daverowntree/SmartDesk/KiCAD5/SmartDesk_v1p0-PCB-top-3D.png

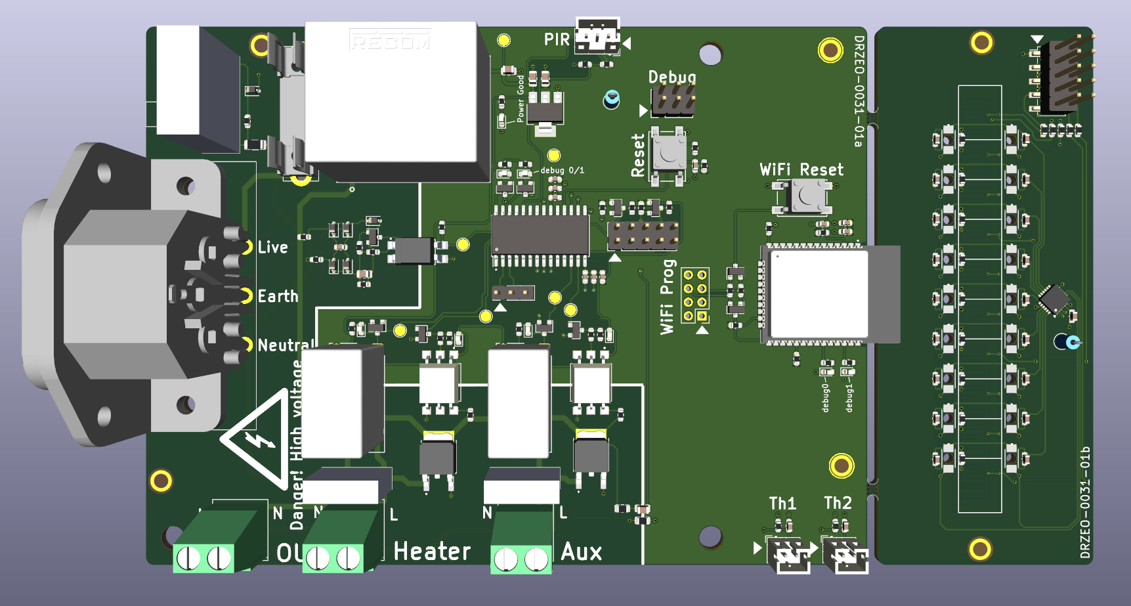
KiCAD5/SmartDesk_v1p0-PCB-top-3D.png
