daverowntree/SmartDesk/KiCAD5/ESP32_Pinout.jpg

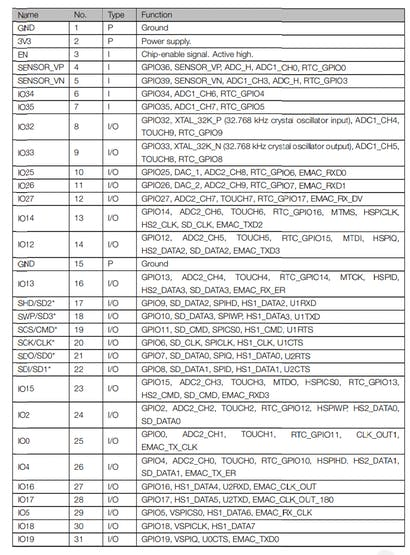
KiCAD5/ESP32_Pinout.jpg
