daverowntree/SmartDesk/KiCAD5/Screenshot from 2024-06-14 21-21-42.png

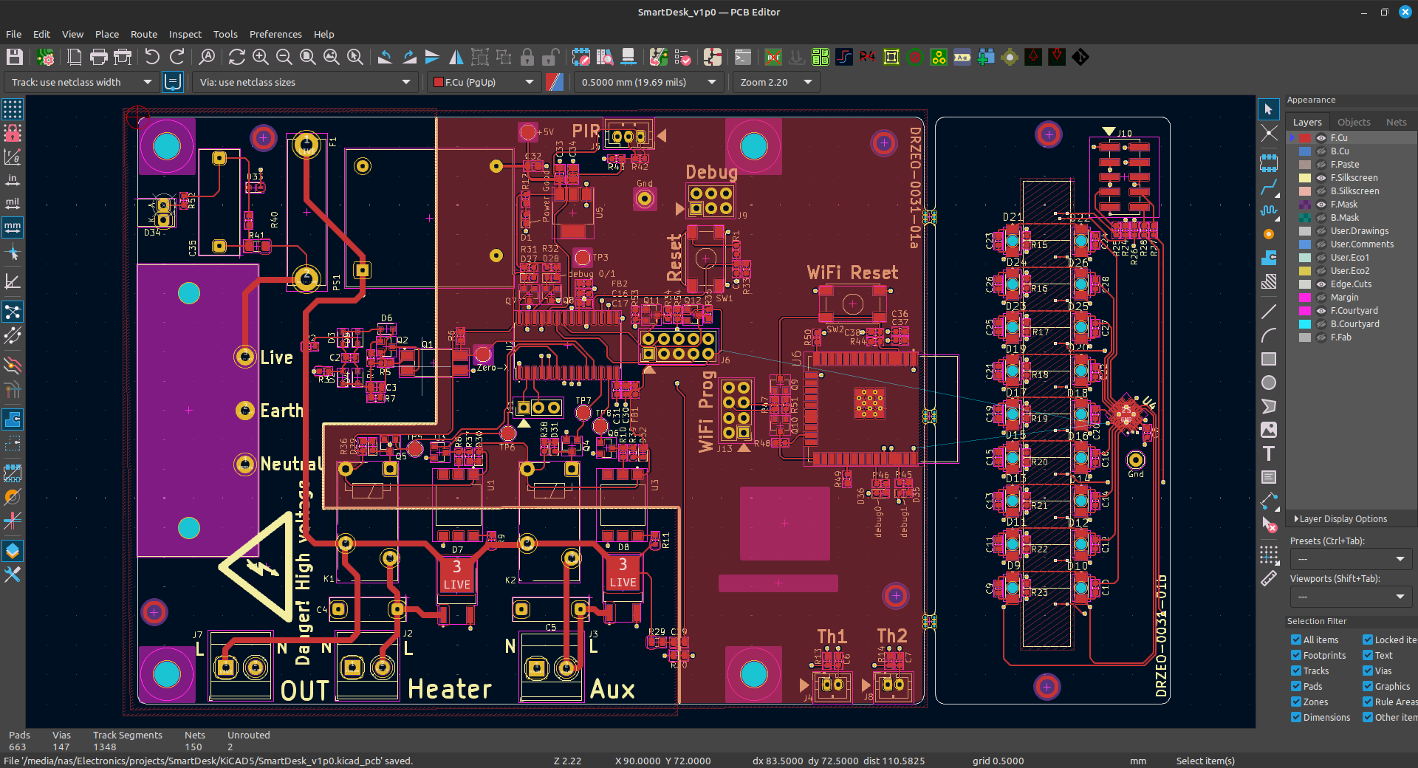
KiCAD5/Screenshot from 2024-06-14 21-21-42.png
