daverowntree/SmartDesk/KiCAD5/SmartDesk_v1p0-PCB-bot-3D.png

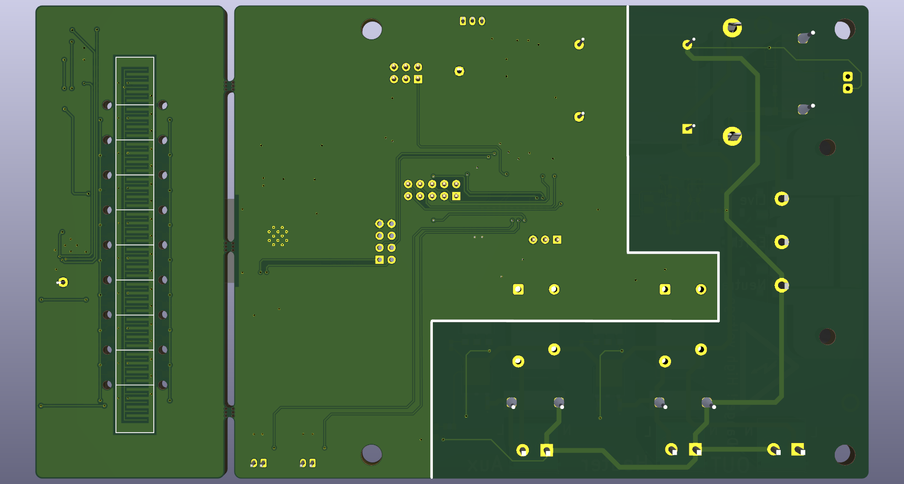
KiCAD5/SmartDesk_v1p0-PCB-bot-3D.png
