daverowntree/SmartDesk/KiCAD5/triacDriver.png

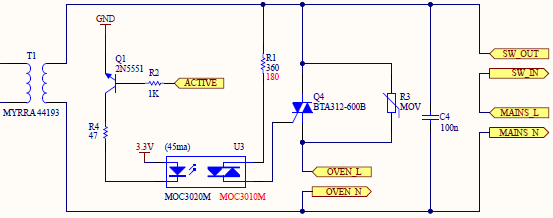
KiCAD5/triacDriver.png
