daverowntree/SmartDesk/KiCAD5/zcd2.gif

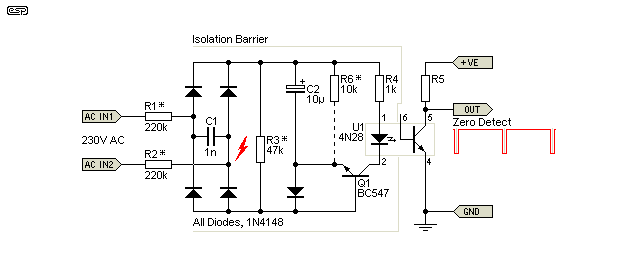
KiCAD5/zcd2.gif
