daverowntree/SmartDesk/KiCAD5/zcd.png

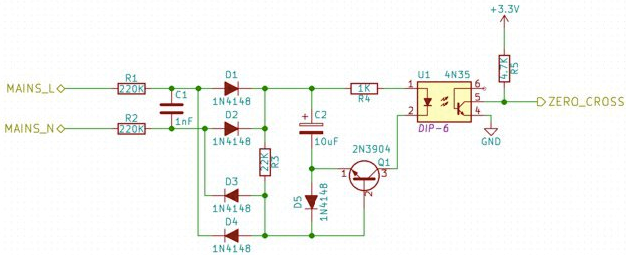
KiCAD5/zcd.png
