daverowntree/SmartDesk/FreeCAD/TE-Relay.step

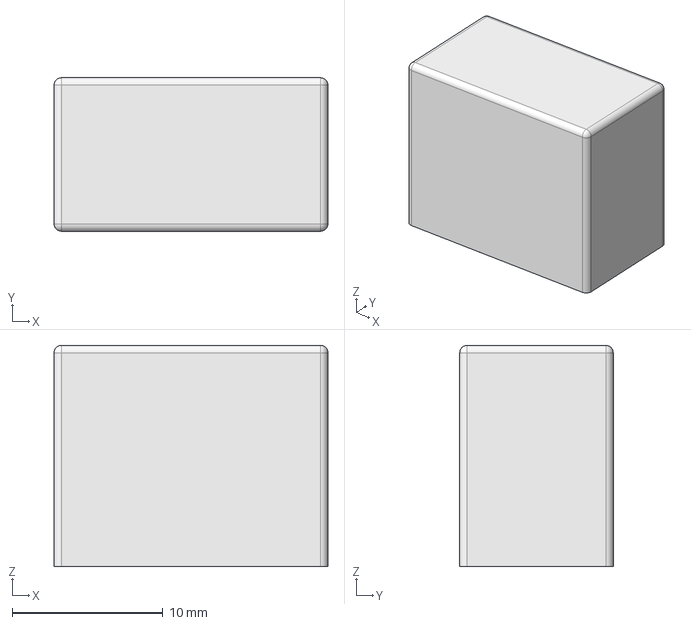
[picture p8: CAD file, 2024-06-14]
FreeCAD/TE-Relay.step
18.2 x 10.2 x 14.7 mm
