daverowntree/SmartDesk/(list of files, cad)

Other CAD files:
FreeCAD/TE-Relay.FCStd
