daverowntree/SmartDesk/LTSpice/power_indicator.asc

C2: cap; 220n
D1: LED; QTLP690C
D3: diode; 1N4148
R1: res; 100
R2: res; 1000k
V2: voltage; SINE(0 325.27 50)
Named nets: live, neutral, 0
.tran 0 5.2s 5s startup
