daverowntree/SmartDesk/LTSpice/ZCD.asc

C1: cap; 1n
C2: cap; 10µ
D1: diode; 1N4148
D2: diode; 1N4148
D3: diode; 1N4148
D4: diode; 1N4148
D5: diode; 1N4148
Q1: npn; BC547B
R1: res; 1000k
R2: res; 47k
R3: res; 250
R4: res; 4k7
R5: res; 100k
R6: res; 100k
U1: PC817A
V1: voltage; 3v3
V2: voltage; SINE(0 325.27 50)
Named nets: 0, zcd, top, bot, trig, live, neutral
.tran 0 5.2s 5s startup
