daverowntree/SmartDesk/KiCAD5/SmartDesk_v1p0.kicad_pcb

## KiCad design KiCAD5/SmartDesk_v1p0.kicad_pcb (2024-06-14)

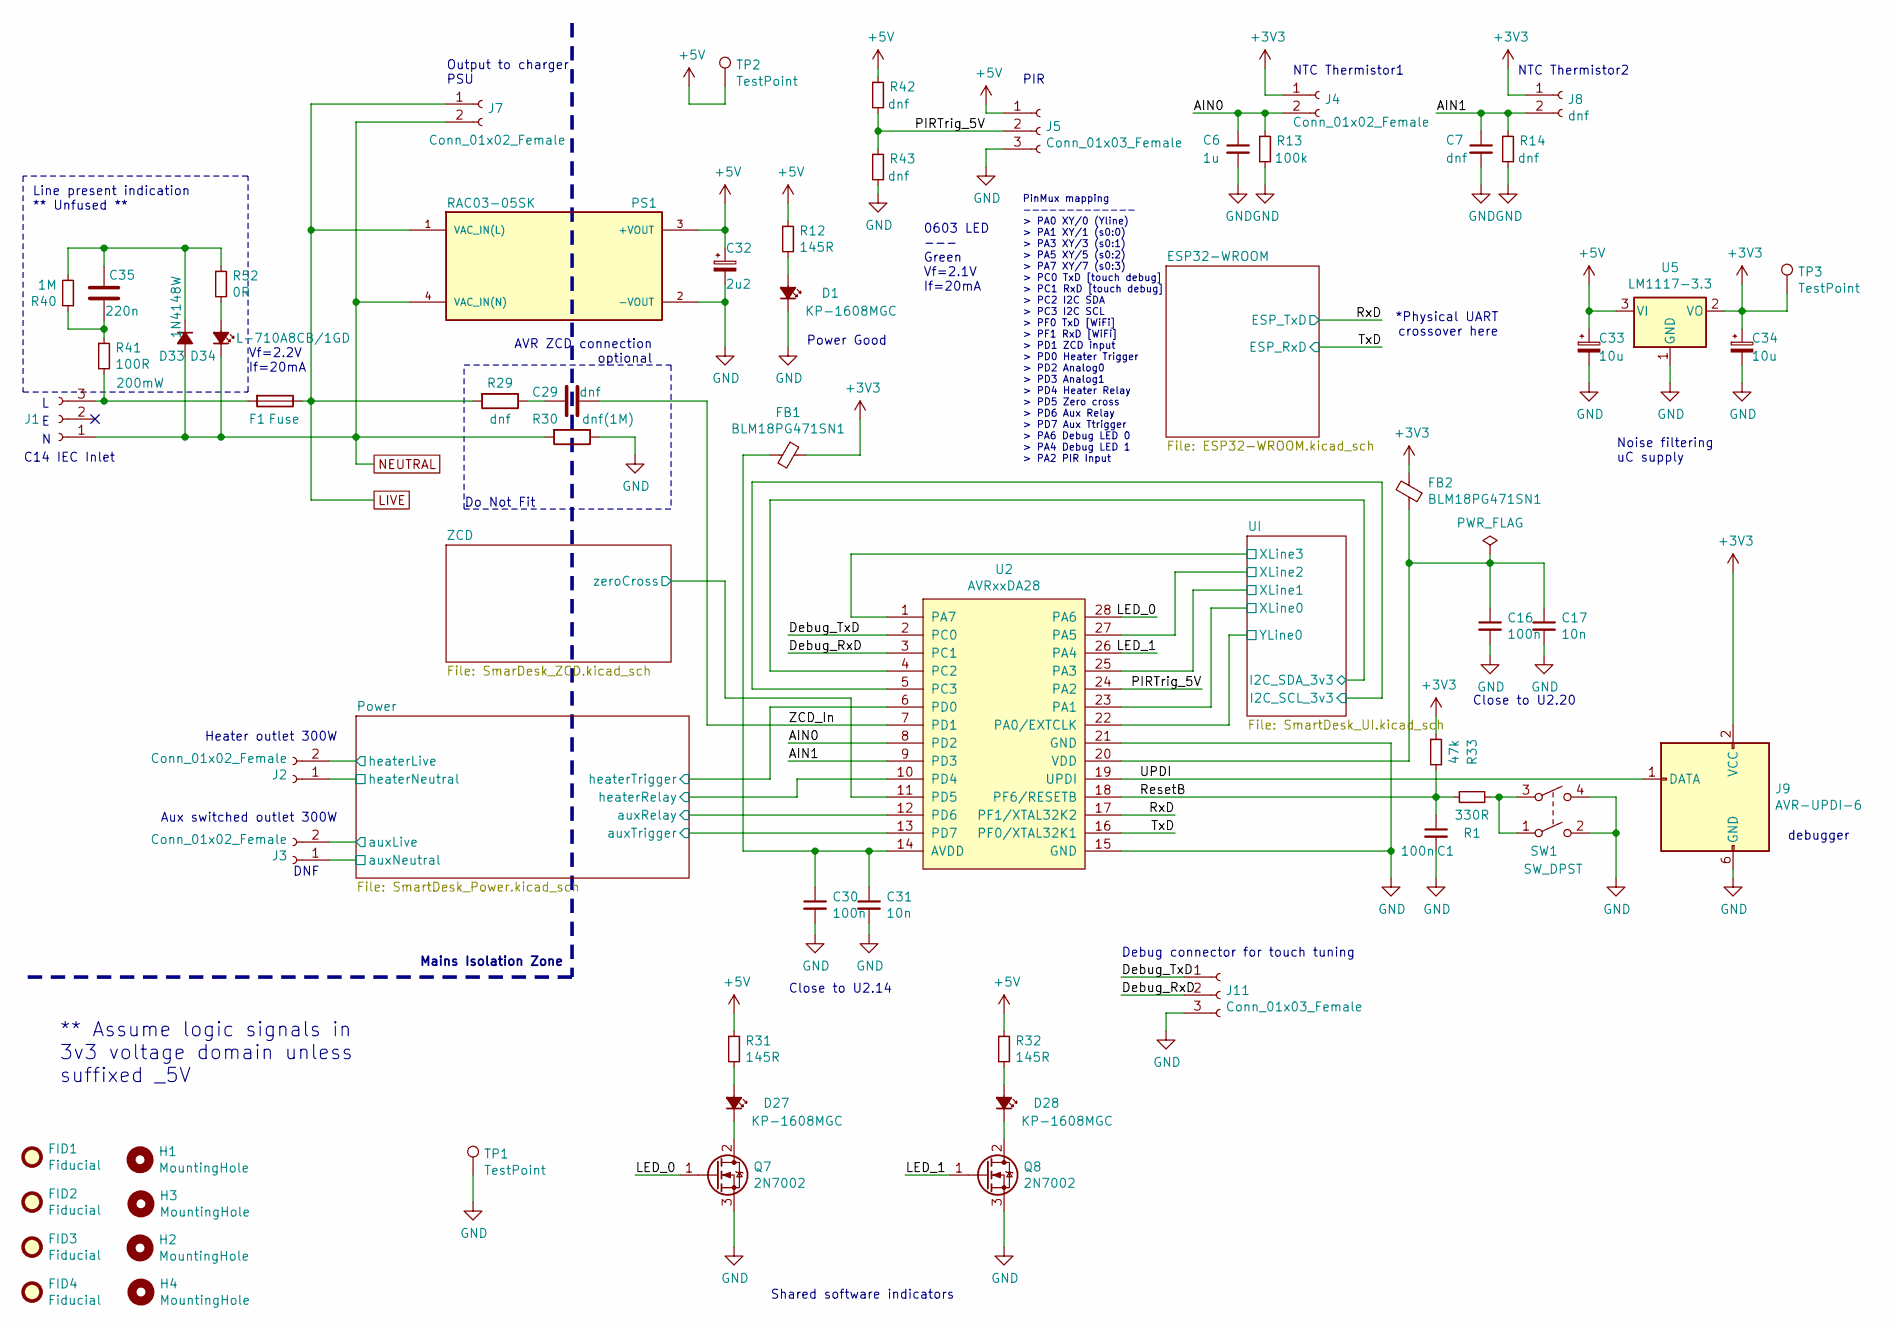
[picture p14: schematic SmartDesk_v1p0.kicad_sch, Smart Desk Main PCB]

Parts:
C1, C16, C30: 100n; C_0603_1608Metric
C6: 1u; C_0603_1608Metric
C7: dnf; C_0603_1608Metric
C17, C31: 10n; C_0603_1608Metric
C29: dnf; C_0805_2012Metric
C32: 2u2; C_0805_2012Metric
C33, C34: 10u; C_0805_2012Metric
C35: 220n; B32922C3224
D1, D27, D28: KP-1608MGC; LED_0603_1608Metric
D33: 1N4148W; D_SOD-323
D34: L-710A8CB/1GD; L-710A8CB
F1: Fuse; Bulgin-FX0321
FB1, FB2: BLM18PG471SN1; C_0603_1608Metric
FID1, FID2, FID3, FID4: Fiducial; Fiducial_Modern_CopperTop
H1, H2, H3, H4: MountingHole; MountingHole_4.3mm_M4
J1: Conn_01x03_Female; Bulgin-PX0580-PC
J2, J3, J7: Conn_01x02_Female; TerminalBlock_Phoenix_MKDS-3-2-5.08_1x02_P5.08mm_Horizontal
J4: Conn_01x02_Female; JST_PH_B2B-PH-K_1x02_P2.00mm_Vertical
J5: Conn_01x03_Female; JST_PH_B3B-PH-K_1x03_P2.00mm_Vertical
J8: dnf; JST_PH_B2B-PH-K_1x02_P2.00mm_Vertical
J9: AVR-UPDI-6; PinHeader_2x03_P2.54mm_Vertical
J11: Conn_01x03_Female; PinHeader_1x03_P2.54mm_Vertical
PS1: RAC03-05SK; CONV_RAC03-05SK
Q7, Q8: 2N7002; SOT-23
R1: 330R; R_0603_1608Metric
R12, R31, R32: 145R; R_0603_1608Metric
R13: 100k; R_0603_1608Metric
R14, R42, R43: dnf; R_0603_1608Metric
R29: dnf; R_0805_2012Metric
R30: dnf(1M); R_0805_2012Metric
R33: 47k; R_0603_1608Metric
R40: 1M; R_0603_1608Metric
R41: 100R; R_1206_3216Metric
R52: 0R; R_0603_1608Metric
SW1: SW_DPST; 2-1437565-8
TP1: TestPoint; TestPoint_Loop_D1.80mm_Drill1.0mm_Beaded
TP2, TP3: TestPoint; TestPoint_Pad_D2.0mm
U2: AVRxxDA28; SOIC-28W_7.5x17.9mm_P1.27mm
U5: LM1117-3.3; SOT-223-lm1117

Connections:
+3V3: C34.1, FB1.1, FB2.2, J4.1, J8.1, J9.2 (VCC), R33.1, TP3.1, U5.2 (VO); also elsewhere on the board
+5V: C32.1, C33.1, J5.1, PS1.3 (+VOUT), R12.1, R31.1, R32.1, R42.1, TP2.1, U5.3 (VI); also elsewhere on the board
/AIN0: C6.1, J4.2, R13.1, U2.8 (PD2)
/AIN1: C7.1, J8.2, R14.1, U2.9 (PD3)
/Debug_RxD: J11.2, U2.3 (PC1)
/Debug_TxD: J11.1, U2.2 (PC0)
/LED_0: Q7.1 (G), U2.28 (PA6)
/LED_1: Q8.1 (G), U2.26 (PA4)
/PIRTrig_5V: J5.2, R42.2, R43.1, U2.24 (PA2)
/Power/auxLive: J3.2; also elsewhere on the board
/Power/auxRelay: U2.12 (PD6); also elsewhere on the board
/Power/auxTrigger: U2.13 (PD7); also elsewhere on the board
/Power/heaterLive: J2.2; also elsewhere on the board
/Power/heaterRelay: U2.10 (PD4); also elsewhere on the board
/Power/heaterTrigger: U2.6 (PD0); also elsewhere on the board
/ResetB: C1.1, R1.2, R33.2, U2.18 (PF6/RESETB)
/RxD: U2.17 (PF1/XTAL32K2); also elsewhere on the board
/TxD: U2.16 (PF0/XTAL32K1); also elsewhere on the board
/UI/I2C_SCL_3v3: U2.5 (PC3); also elsewhere on the board
/UI/I2C_SDA_3v3: U2.4 (PC2); also elsewhere on the board
/UI/XLine0: U2.23 (PA1); also elsewhere on the board
/UI/XLine1: U2.25 (PA3); also elsewhere on the board
/UI/XLine2: U2.27 (PA5); also elsewhere on the board
/UI/XLine3: U2.1 (PA7); also elsewhere on the board
/UI/YLine0: U2.22 (PA0/EXTCLK); also elsewhere on the board
/UPDI: J9.1 (DATA), U2.19 (UPDI)
/ZCD/zeroCross: U2.11 (PD5); also elsewhere on the board
/ZCD_In: C29.1, U2.7 (PD1)
GND: C1.2, C6.2, C7.2, C16.2, C17.2, C30.2, C31.2, C32.2, C33.2, C34.2, D1.1 (K), J5.3, J9.6 (GND), J11.3, PS1.2 (-VOUT), Q7.3 (S), Q8.3 (S), R13.2, R14.2, R30.1, R43.2, SW1.2, SW1.4, TP1.1, U2.15 (GND), U2.21 (GND), U5.1 (GND); also elsewhere on the board
LIVE: F1.1, J7.1, PS1.1 (VAC_IN(L)), R29.2; also elsewhere on the board
NEUTRAL: D33.2 (A), D34.1 (K), J1.1, J2.1, J3.1, J7.2, PS1.4 (VAC_IN(N)), R30.2; also elsewhere on the board
unnamed: C16.1, C17.1, FB2.1, U2.20 (VDD)
unnamed: C29.2, R29.1
unnamed: C30.1, C31.1, FB1.2, U2.14 (AVDD)
unnamed: C35.1, R40.1, R41.1
unnamed: C35.2, D33.1 (K), R40.2, R52.1
unnamed: D1.2 (A), R12.2
unnamed: D27.1 (K), Q7.2 (D)
unnamed: D27.2 (A), R31.2
unnamed: D28.1 (K), Q8.2 (D)
unnamed: D28.2 (A), R32.2
unnamed: D34.2 (A), R52.2
unnamed: F1.2, J1.3, R41.2
unnamed: R1.1, SW1.1, SW1.3

Notes on the sheet:
DNF
Vf=2.2V If=20mA
Do Not Fit
Shared software indicators
C14 IEC Inlet
PIR
NTC Thermistor2
Close to U2.14
Mains Isolation Zone
Power Good
Heater outlet 300W
*Physical UART crossover here
Output to charger PSU
0603 LED --- Green Vf=2.1V If=20mA
Debug connector for touch tuning
Noise filtering uC supply
Line present indication ** Unfused **
PinMux mapping ------------- > PA0 XY/0 (Yline) > PA1 XY/1 (s0:0) > PA3 XY/3 (s0:1) > PA5 XY/5 (s0:2) > PA7 XY/7 (s0:3) > PC0 TxD [touch debug] > PC1 RxD [touch debug] > PC2 I2C SDA > PC3 I2C SCL > PF0 TxD [WiFi] > PF1 RxD [WiFi] > PD1 ZCD input > PD0 Heater Trigger > PD2 Analog0 > PD3 Analog1 > PD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
** Assume logic signals in 3v3 voltage domain unless suffixed _5V
Close to U2.20
debugger
Aux switched outlet 300W
NTC Thermistor1
AVR ZCD connection optional

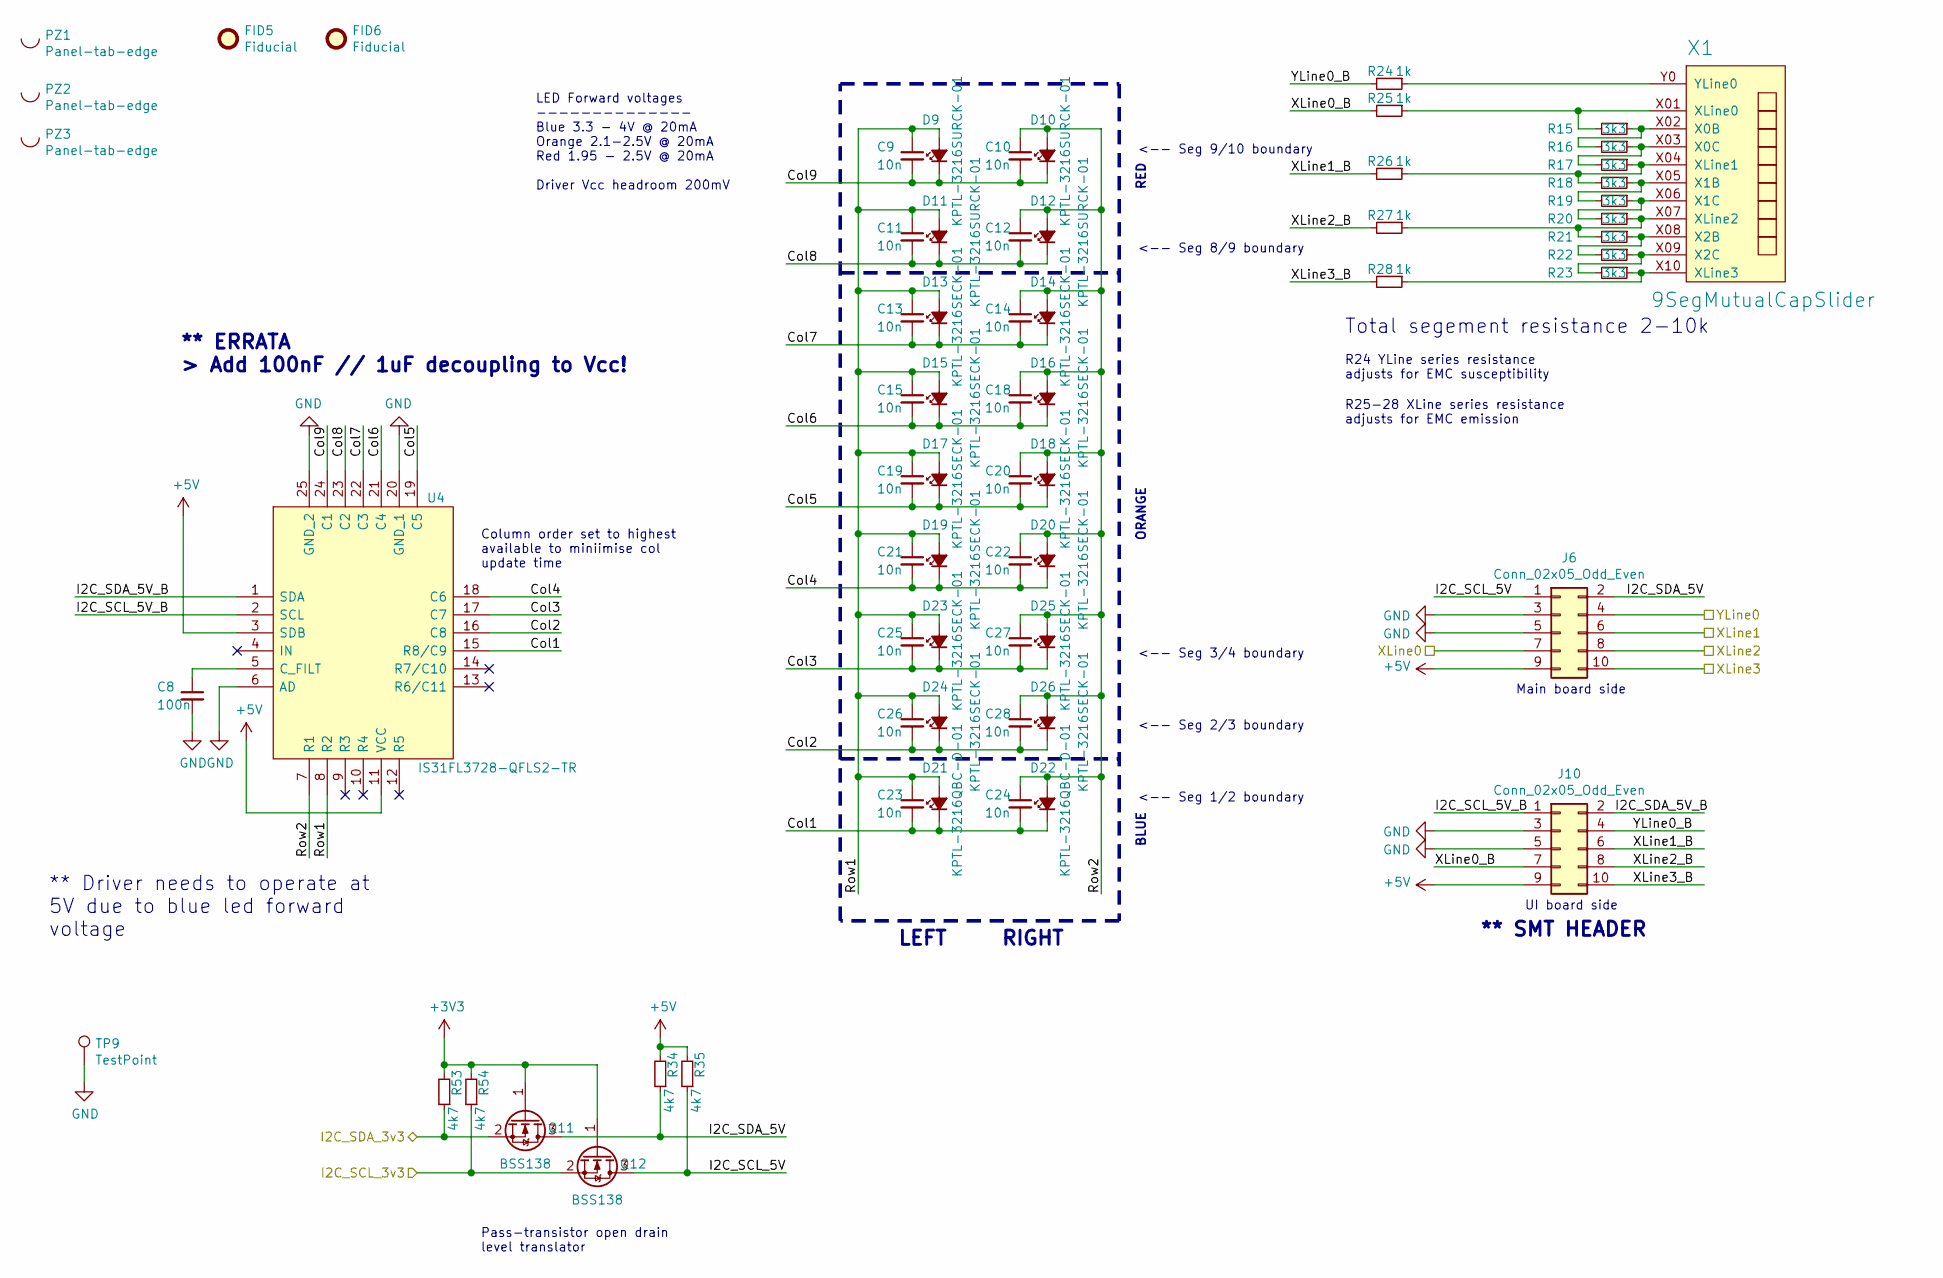
[picture p15: schematic SmartDesk_UI.kicad_sch, Smart Desk Main PCB]

Parts:
C8: 100n; C_0603_1608Metric
C9, C10, C11, C12, C13, C14, C15, C18, C19, C20, C21, C22, C23, C24, C25, C26, C27, C28: 10n; C_0603_1608Metric
D9, D10, D11, D12: KPTL-3216SURCK-01; VARC3216X102N
D13, D14, D15, D16, D17, D18, D19, D20, D23, D24, D25, D26: KPTL-3216SECK-01; VARC3216X102N
D21, D22: KPTL-3216QBC-D-01; VARC3216X102N
FID5, FID6: Fiducial; Fiducial_Modern_CopperTop
J6: Conn_02x05_Odd_Even; PinHeader_2x05_P2.54mm_Vertical
J10: Conn_02x05_Odd_Even; PinHeader_2x05_P2.54mm_Vertical_SMD
PZ1, PZ2, PZ3: Panel-tab-edge; mouse-bite-2mm-slot
Q11, Q12: BSS138; SOT-23
R15, R16, R17, R18, R19, R20, R21, R22, R23: 3k3; R_0603_1608Metric
R24, R25, R26, R27, R28: 1k; R_0603_1608Metric
R34, R35, R53, R54: 4k7; R_0603_1608Metric
TP9: TestPoint; TestPoint_Loop_D1.80mm_Drill1.0mm_Beaded
U4: IS31FL3728-QFLS2-TR; QFN50P400X400X80-25N-D; Manufacturer_Part_Number IS31FL3728-QFLS2-TR; Mouser Part Number 870-IS31FL3728QFLS2R
X1: 9SegMutualCapSlider

Connections:
+3V3: Q11.1 (G), Q12.1 (G), R53.2, R54.2; also elsewhere on the board
+5V: J6.9, J10.9, R34.2, R35.2, U4.3 (SDB), U4.11 (VCC); also elsewhere on the board
/UI/Col1: C23.2, C24.2, D21.1 (K), D22.1 (K), U4.15 (R8/C9)
/UI/Col2: C26.2, C28.2, D24.1 (K), D26.1 (K), U4.16 (C8)
/UI/Col3: C25.2, C27.2, D23.1 (K), D25.1 (K), U4.17 (C7)
/UI/Col4: C21.2, C22.2, D19.1 (K), D20.1 (K), U4.18 (C6)
/UI/Col5: C19.2, C20.2, D17.1 (K), D18.1 (K), U4.19 (C5)
/UI/Col6: C15.2, C18.2, D15.1 (K), D16.1 (K), U4.21 (C4)
/UI/Col7: C13.2, C14.2, D13.1 (K), D14.1 (K), U4.22 (C3)
/UI/Col8: C11.2, C12.2, D11.1 (K), D12.1 (K), U4.23 (C2)
/UI/Col9: C9.2, C10.2, D9.1 (K), D10.1 (K), U4.24 (C1)
/UI/I2C_SCL_3v3: Q12.2 (S), R54.1; also elsewhere on the board
/UI/I2C_SCL_5V: J6.1, Q12.3 (D), R35.1
/UI/I2C_SCL_5V_B: J10.1, U4.2 (SCL)
/UI/I2C_SDA_3v3: Q11.2 (S), R53.1; also elsewhere on the board
/UI/I2C_SDA_5V: J6.2, Q11.3 (D), R34.1
/UI/I2C_SDA_5V_B: J10.2, U4.1 (SDA)
/UI/Row1: C9.1, C11.1, C13.1, C15.1, C19.1, C21.1, C23.1, C25.1, C26.1, D9.2 (A), D11.2 (A), D13.2 (A), D15.2 (A), D17.2 (A), D19.2 (A), D21.2 (A), D23.2 (A), D24.2 (A), U4.8 (R2)
/UI/Row2: C10.1, C12.1, C14.1, C18.1, C20.1, C22.1, C24.1, C27.1, C28.1, D10.2 (A), D12.2 (A), D14.2 (A), D16.2 (A), D18.2 (A), D20.2 (A), D22.2 (A), D25.2 (A), D26.2 (A), U4.7 (R1)
/UI/XLine0: J6.7; also elsewhere on the board
/UI/XLine0_B: J10.7, R25.2
/UI/XLine1: J6.6; also elsewhere on the board
/UI/XLine1_B: J10.6, R26.2
/UI/XLine2: J6.8; also elsewhere on the board
/UI/XLine2_B: J10.8, R27.2
/UI/XLine3: J6.10; also elsewhere on the board
/UI/XLine3_B: J10.10, R28.2
/UI/YLine0: J6.4; also elsewhere on the board
/UI/YLine0_B: J10.4, R24.2
GND: C8.2, J6.3, J6.5, J10.3, J10.5, TP9.1, U4.6 (AD), U4.20 (GND_1), U4.25 (GND_2); also elsewhere on the board
unnamed: C8.1, U4.5 (C_FILT)
unnamed: R15.1, R16.2, X1.X02 (X0B)
unnamed: R15.2, R25.1, X1.X01 (XLine0)
unnamed: R16.1, R17.2, X1.X03 (X0C)
unnamed: R17.1, R18.2, R26.1, X1.X04 (XLine1)
unnamed: R18.1, R19.2, X1.X05 (X1B)
unnamed: R19.1, R20.2, X1.X06 (X1C)
unnamed: R20.1, R21.2, R27.1, X1.X07 (XLine2)
unnamed: R21.1, R22.2, X1.X08 (X2B)
unnamed: R22.1, R23.2, X1.X09 (X2C)
unnamed: R23.1, R28.1, X1.X10 (XLine3)
unnamed: R24.1, X1.Y0 (YLine0)

Notes on the sheet:
Main board side
LED Forward voltages -------------- Blue 3.3 - 4V @ 20mA Orange 2.1-2.5V @ 20mA Red 1.95 - 2.5V @ 20mA Driver Vcc headroom 200mV
RED
RIGHT
Column order set to highest available to miniimise col update time
<-- Seg 2/3 boundary
** Driver needs to operate at 5V due to blue led forward voltage
** SMT HEADER
Total segement resistance 2-10k
<-- Seg 3/4 boundary
<-- Seg 9/10 boundary
UI board side
** ERRATA > Add 100nF // 1uF decoupling to Vcc!
LEFT
<-- Seg 8/9 boundary
ORANGE
R25-28 XLine series resistance adjusts for EMC emission
R24 YLine series resistance adjusts for EMC susceptibility
<-- Seg 1/2 boundary
Pass-transistor open drain level translator
BLUE

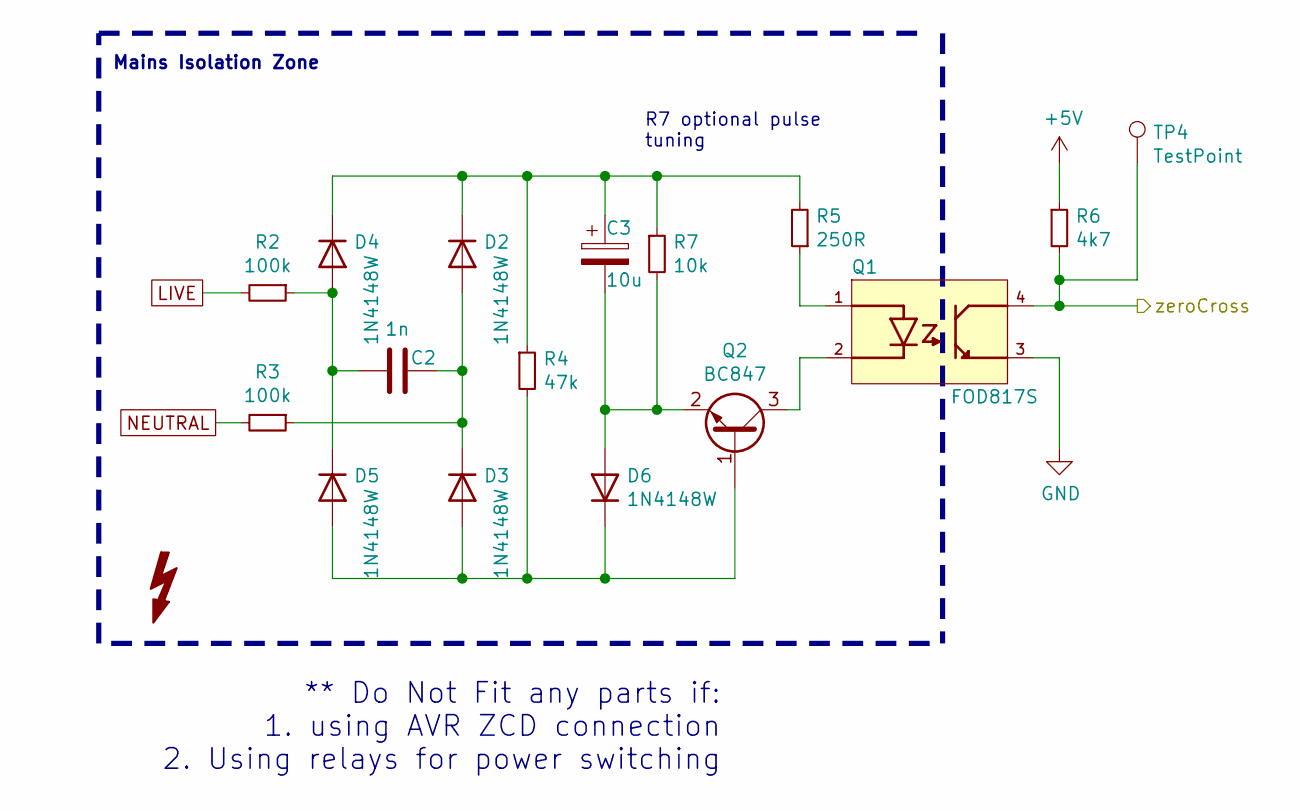
[picture p16: schematic SmarDesk_ZCD.kicad_sch, Smart Desk Main PCB]

Parts:
C2: 1n; C_0603_1608Metric
C3: 10u; C_0805_2012Metric
D2, D3, D4, D5, D6: 1N4148W; D_SOD-323
Q1: FOD817S; SOIC254P1016X385-4N
Q2: BC847; SOT-23
R2, R3: 100k; R_0603_1608Metric
R4: 47k; R_0603_1608Metric
R5: 250R; R_0603_1608Metric
R6: 4k7; R_0603_1608Metric
R7: 10k; R_0603_1608Metric
S1: SYM_Flash_Small; Symbol_Highvoltage_Type2_Silk_Small
TP4: TestPoint; TestPoint_Pad_D2.0mm

Connections:
+5V: R6.1; also elsewhere on the board
/ZCD/zeroCross: Q1.4, R6.2, TP4.1; also elsewhere on the board
GND: Q1.3; also elsewhere on the board
LIVE: R2.2; also elsewhere on the board
NEUTRAL: R3.2; also elsewhere on the board
unnamed: C2.1, D2.2 (A), D3.1 (K), R3.1
unnamed: C2.2, D4.2 (A), D5.1 (K), R2.1
unnamed: C3.1, D2.1 (K), D4.1 (K), R4.1, R5.2, R7.1
unnamed: C3.2, D6.2 (A), Q2.2 (E), R7.2
unnamed: D3.2 (A), D5.2 (A), D6.1 (K), Q2.1 (B), R4.2
unnamed: Q1.1, R5.1
unnamed: Q1.2, Q2.3 (C)

Notes on the sheet:
Mains Isolation Zone
R7 optional pulse tuning
** Do Not Fit any parts if: 1. using AVR ZCD connection 2. Using relays for power switching

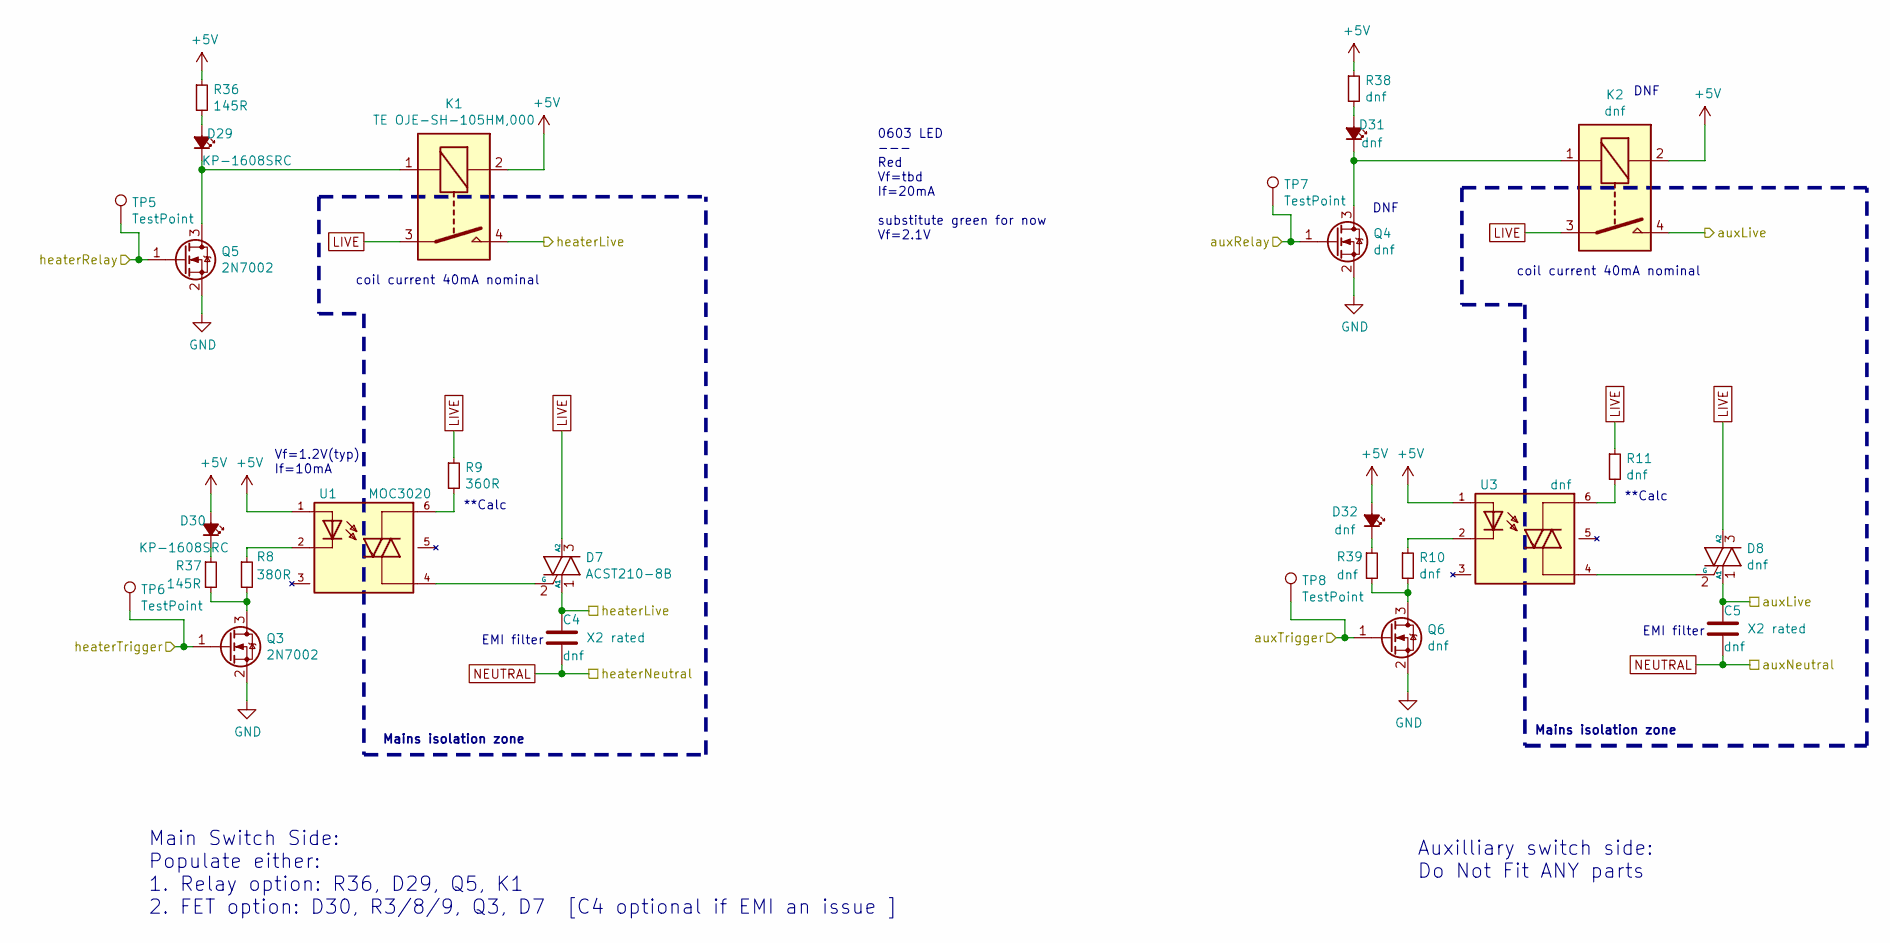
[picture p17: schematic SmartDesk_Power.kicad_sch, Smart Desk Main PCB]

Parts:
C4, C5: dnf; B32921C3223M289; Rating X2 rated
D7: ACST210-8B; DPAK228P987X240-3N
D8: dnf; DPAK228P987X240-3N
D29, D30: KP-1608SRC; LED_0603_1608Metric
D31, D32: dnf; LED_0603_1608Metric
K1: TE OJE-SH-105HM,000; TE_OJE-SH-105HM
K2: dnf; TE_OJE-SH-105HM
Q3, Q5: 2N7002; SOT-23
Q4, Q6: dnf; SOT-23
R8: 380R; R_0603_1608Metric
R9: 360R; R_0603_1608Metric
R10, R11, R38, R39: dnf; R_0603_1608Metric
R36, R37: 145R; R_0603_1608Metric
TP5, TP6, TP7, TP8: TestPoint; TestPoint_Pad_D2.0mm
U1: MOC3020; MOC302X-SON6
U3: dnf; MOC302X-SON6

Connections:
+5V: D30.2 (A), D32.2 (A), K1.2, K2.2, R36.1, R38.1, U1.1, U3.1; also elsewhere on the board
/Power/auxLive: C5.1, D8.1 (A1), K2.4; also elsewhere on the board
/Power/auxRelay: Q4.1 (G), TP7.1; also elsewhere on the board
/Power/auxTrigger: Q6.1 (G), TP8.1; also elsewhere on the board
/Power/heaterLive: C4.1, D7.1 (A1), K1.4; also elsewhere on the board
/Power/heaterRelay: Q5.1 (G), TP5.1; also elsewhere on the board
/Power/heaterTrigger: Q3.1 (G), TP6.1; also elsewhere on the board
GND: Q3.2 (S), Q4.2 (S), Q5.2 (S), Q6.2 (S); also elsewhere on the board
LIVE: D7.3 (A2), D8.3 (A2), K1.3, K2.3, R9.1, R11.1; also elsewhere on the board
NEUTRAL: C4.2, C5.2; also elsewhere on the board
unnamed: D7.2 (G), U1.4
unnamed: D8.2 (G), U3.4
unnamed: D29.1 (K), K1.1, Q5.3 (D)
unnamed: D29.2 (A), R36.2
unnamed: D30.1 (K), R37.1
unnamed: D31.1 (K), K2.1, Q4.3 (D)
unnamed: D31.2 (A), R38.2
unnamed: D32.1 (K), R39.1
unnamed: Q3.3 (D), R8.2, R37.2
unnamed: Q6.3 (D), R10.2, R39.2
unnamed: R8.1, U1.2
unnamed: R9.2, U1.6
unnamed: R10.1, U3.2
unnamed: R11.2, U3.6

Notes on the sheet:
Mains isolation zone
Auxilliary switch side: Do Not Fit ANY parts
0603 LED --- Red Vf=tbd If=20mA substitute green for now Vf=2.1V
DNF
EMI filter
**Calc
Main Switch Side: Populate either: 1. Relay option: R36, D29, Q5, K1 2. FET option: D30, R3/8/9, Q3, D7 [C4 optional if EMI an issue ]
coil current 40mA nominal
Vf=1.2V(typ) If=10mA

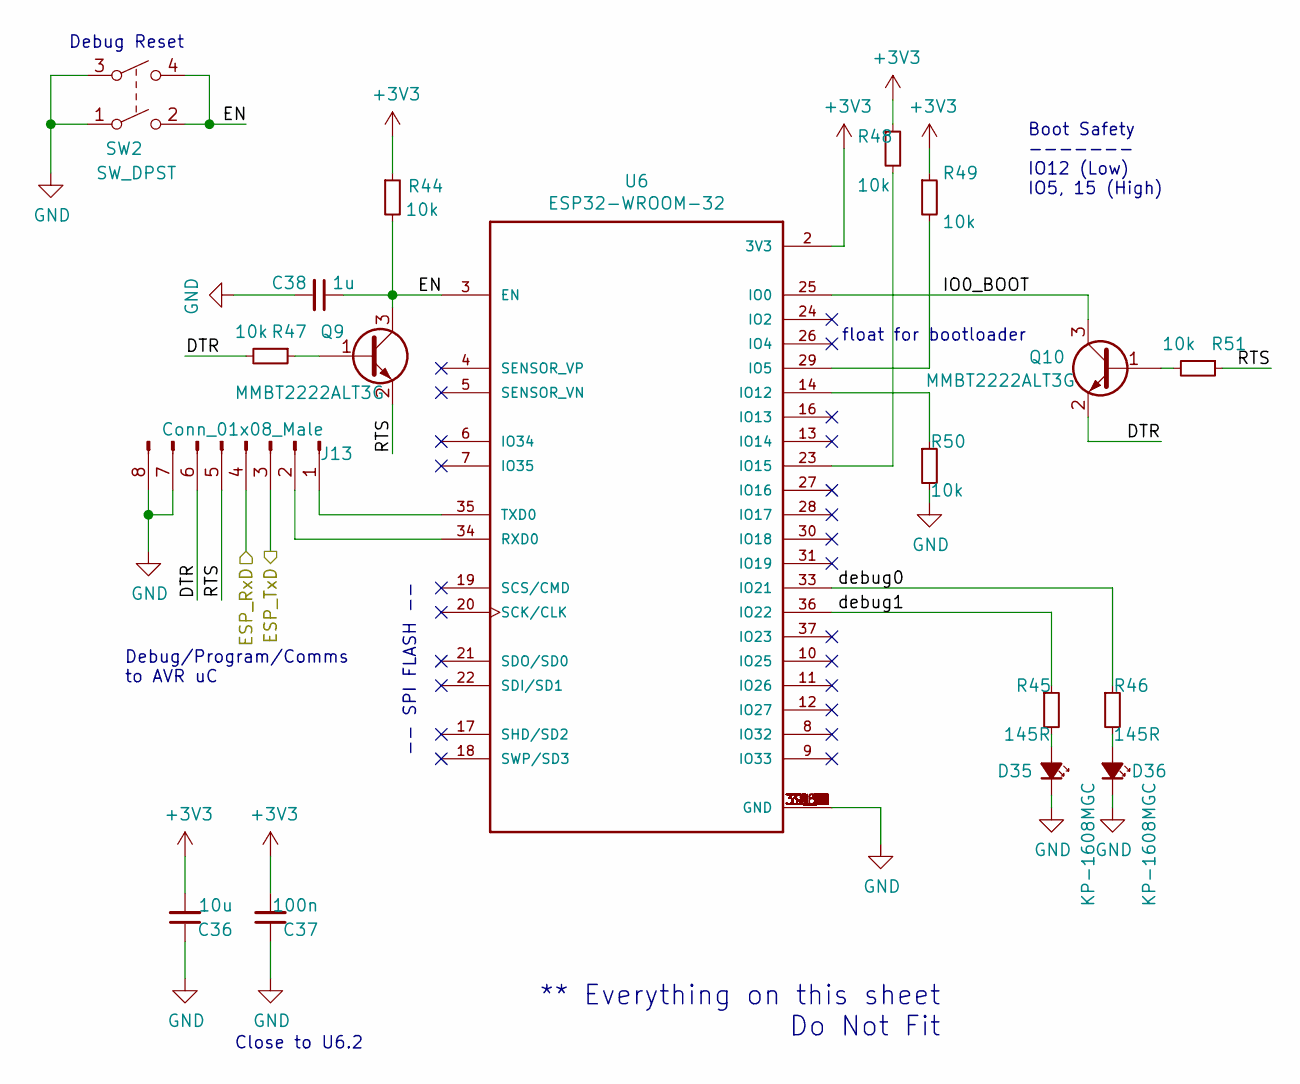
[picture p18: schematic ESP32-WROOM.kicad_sch, Smart Desk Main PCB]

Parts:
C36: 10u; C_0603_1608Metric
C37: 100n; C_0603_1608Metric
C38: 1u; C_0603_1608Metric
D35, D36: KP-1608MGC; LED_0603_1608Metric
J13: Conn_01x08_Male; Pin_Header_Straight_2x04_Pitch2.54mm
Q9, Q10: MMBT2222ALT3G; SOT-23
R44, R47, R48, R49, R50, R51: 10k; R_0603_1608Metric
R45, R46: 145R; R_0603_1608Metric
SW2: SW_DPST; 2-1437565-8
U6: ESP32-WROOM-32; MODULE_ESP32-WROOM-32

Connections:
+3V3: C36.2, C37.2, R44.1, R48.1, R49.1, U6.2 (3V3); also elsewhere on the board
/ESP32-WROOM/DTR: J13.6, Q10.2 (E), R47.2
/ESP32-WROOM/EN: C38.1, Q9.3 (C), R44.2, SW2.2, SW2.4, U6.3 (EN)
/ESP32-WROOM/IO0_BOOT: Q10.3 (C), U6.25 (IO0)
/ESP32-WROOM/RTS: J13.5, Q9.2 (E), R51.1
/ESP32-WROOM/debug0: R46.1, U6.33 (IO21)
/ESP32-WROOM/debug1: R45.1, U6.36 (IO22)
/RxD: J13.3; also elsewhere on the board
/TxD: J13.4; also elsewhere on the board
GND: C36.1, C37.1, C38.2, D35.1 (K), D36.1 (K), J13.7, J13.8, R50.2, SW2.1, SW2.3, U6.1 (GND), U6.15 (GND), U6.38 (GND), U6.39_1 (GND), U6.39_2 (GND), U6.39_3 (GND), U6.39_4 (GND), U6.39_5 (GND), U6.39_6 (GND), U6.39_7 (GND), U6.39_8 (GND), U6.39_9 (GND), U6.39_10 (GND), U6.39_11 (GND), U6.39_12 (GND), U6.39_13 (GND), U6.39_14 (GND), U6.39_15 (GND), U6.39_16 (GND), U6.39_17 (GND), U6.39_18 (GND), U6.39_19 (GND), U6.39_20 (GND), U6.39_21 (GND); also elsewhere on the board
unnamed: D35.2 (A), R45.2
unnamed: D36.2 (A), R46.2
unnamed: J13.1, U6.35 (TXD0)
unnamed: J13.2, U6.34 (RXD0)
unnamed: Q9.1 (B), R47.1
unnamed: Q10.1 (B), R51.2
unnamed: R48.2, U6.23 (IO15)
unnamed: R49.2, U6.29 (IO5)
unnamed: R50.1, U6.14 (IO12)

Notes on the sheet:
Boot Safety ------- IO12 (Low) IO5, 15 (High)
** Everything on this sheet Do Not Fit
Debug/Program/Comms to AVR uC
Debug Reset
float for bootloader
Close to U6.2
-- SPI FLASH --

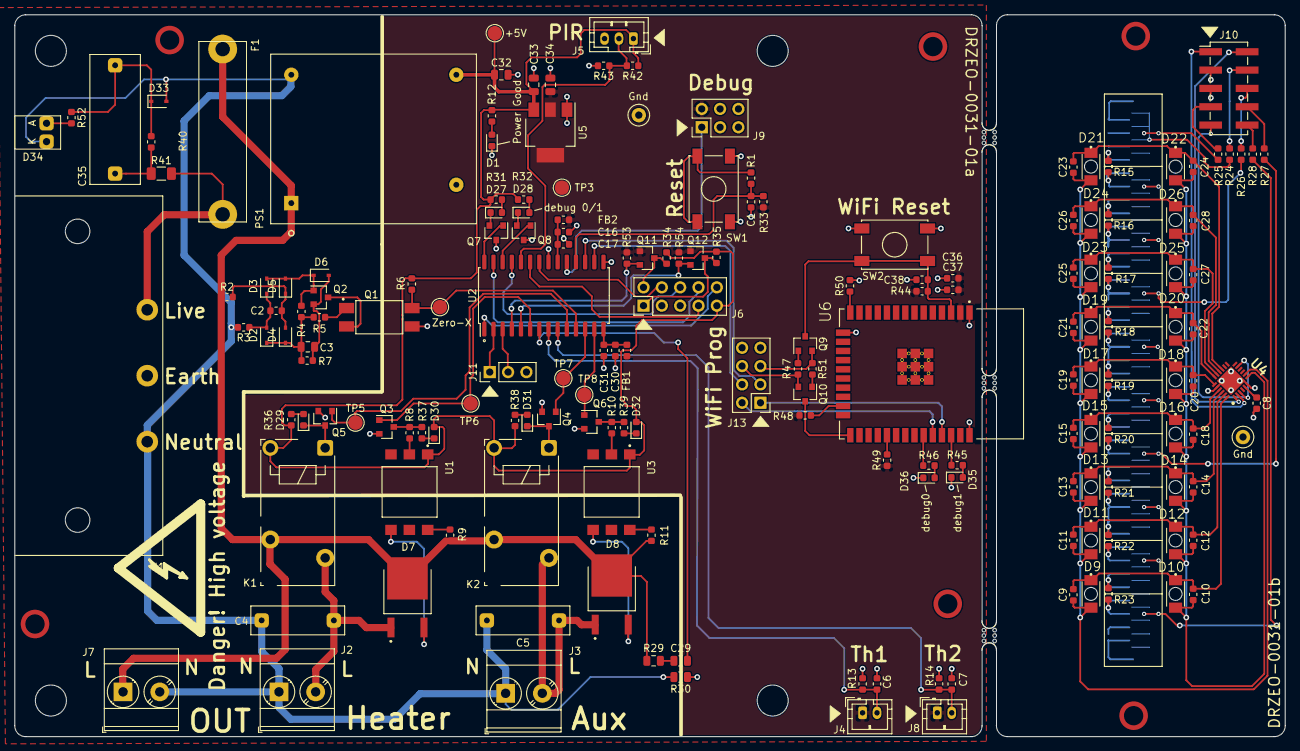
[picture p19: board SmartDesk_v1p0.kicad_pcb from above]

Board: 2 copper layers, 176.0 x 100.0 mm, 190 parts (1 on the bottom side), 112 nets.
