daverowntree/SmartDesk/Atmel Studio/SmartDesk_V1p0/src/driver_init.c

/**
 * \file
 *
 * \brief Driver initialization.
 *
 (c) 2020 Microchip Technology Inc. and its subsidiaries.

    Subject to your compliance with these terms,you may use this software and
    any derivatives exclusively with Microchip products.It is your responsibility
    to comply with third party license terms applicable to your use of third party
    software (including open source software) that may accompany Microchip software.

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
    IN NO EVENT WILL MICROCHIP BE LIABLE FOR ANY INDIRECT, SPECIAL, PUNITIVE,
    INCIDENTAL OR CONSEQUENTIAL LOSS, DAMAGE, COST OR EXPENSE OF ANY KIND
    WHATSOEVER RELATED TO THE SOFTWARE, HOWEVER CAUSED, EVEN IF MICROCHIP HAS
    BEEN ADVISED OF THE POSSIBILITY OR THE DAMAGES ARE FORESEEABLE. TO THE
    FULLEST EXTENT ALLOWED BY LAW, MICROCHIP'S TOTAL LIABILITY ON ALL CLAIMS IN
    ANY WAY RELATED TO THIS SOFTWARE WILL NOT EXCEED THE AMOUNT OF FEES, IF ANY,
    THAT YOU HAVE PAID DIRECTLY TO MICROCHIP FOR THIS SOFTWARE.
 *
 */

/*
 * Code generated by START.
 *
 * This file will be overwritten when reconfiguring your START project.
 * Please copy examples or other code you want to keep to a separate file
 * to avoid losing it when reconfiguring.
 */

#include "driver_init.h"
#include <system.h>

/* configure the pins and initialize the registers */
void USART_initialization(void)
{

	// Set pin direction to input
	debug_RxD_set_dir(PORT_DIR_IN);

	debug_RxD_set_pull_mode(
	    // <y> Pull configuration
	    // <id> pad_pull_config
	    // <PORT_PULL_OFF"> Off
	    // <PORT_PULL_UP"> Pull-up
	    PORT_PULL_OFF);

	// Set pin direction to output

	debug_TxD_set_level(
	    // <y> Initial level
	    // <id> pad_initial_level
	    // <false"> Low
	    // <true"> High
	    false);

	debug_TxD_set_dir(PORT_DIR_OUT);

	USART_init();
}

/* configure the pins and initialize the registers */
void USART_0_initialization(void)
{

	// Set pin direction to input
	RxD_set_dir(PORT_DIR_IN);

	RxD_set_pull_mode(
	    // <y> Pull configuration
	    // <id> pad_pull_config
	    // <PORT_PULL_OFF"> Off
	    // <PORT_PULL_UP"> Pull-up
	    PORT_PULL_OFF);

	// Set pin direction to output

	TxD_set_level(
	    // <y> Initial level
	    // <id> pad_initial_level
	    // <false"> Low
	    // <true"> High
	    false);

	TxD_set_dir(PORT_DIR_OUT);

	USART_0_init();
}

/* configure pins and initialize registers */
void ZCD_0_initialization(void)
{

	// Disable digital input buffer
	ZCD_set_isc(PORT_ISC_INPUT_DISABLE_gc);
	// Disable pull-up resistor
	ZCD_set_pull_mode(PORT_PULL_OFF);

	ZCD_0_init();
}

/* configure pins and initialize registers */
void I2C_0_initialization(void)
{

	SCL_set_level(
	    // <y> Initial level
	    // <id> pad_initial_level
	    // <false"> Low
	    // <true"> High
	    false); // 

	SCL_set_dir(
	    // <y> Pin direction
	    // <id> pad_dir
	    // <PORT_DIR_OFF"> Off
	    // <PORT_DIR_IN"> In
	    // <PORT_DIR_OUT"> Out
	    PORT_DIR_OUT);

	SCL_set_pull_mode(
	    // <y> Pull configuration
	    // <id> pad_pull_config
	    // <PORT_PULL_OFF"> Off
	    // <PORT_PULL_UP"> Pull-up
	    PORT_PULL_OFF);

	SCL_set_inverted(
	    // <y> Invert I/O on pin
	    // <id> pad_invert
	    // <false"> Not inverted
	    // <true"> Inverted
	    false);

	SCL_set_isc(
	    // <y> Pin Input/Sense Configuration
	    // <id> pad_isc
	    // <PORT_ISC_INTDISABLE_gc"> Interrupt disabled but input buffer enabled
	    // <PORT_ISC_BOTHEDGES_gc"> Sense Both Edges
	    // <PORT_ISC_RISING_gc"> Sense Rising Edge
	    // <PORT_ISC_FALLING_gc"> Sense Falling Edge
	    // <PORT_ISC_INPUT_DISABLE_gc"> Digital Input Buffer disabled
	    // <PORT_ISC_LEVEL_gc"> Sense low Level
	    PORT_ISC_INTDISABLE_gc);

	/* set the alternate pin mux */

	PORTMUX.TWIROUTEA |= PORTMUX_TWI01_bm;

	SDA_set_level(
	    // <y> Initial level
	    // <id> pad_initial_level
	    // <false"> Low
	    // <true"> High
	    false); // 

	SDA_set_dir(
	    // <y> Pin direction
	    // <id> pad_dir
	    // <PORT_DIR_OFF"> Off
	    // <PORT_DIR_IN"> In
	    // <PORT_DIR_OUT"> Out
	    PORT_DIR_OUT);

	SDA_set_pull_mode(
	    // <y> Pull configuration
	    // <id> pad_pull_config
	    // <PORT_PULL_OFF"> Off
	    // <PORT_PULL_UP"> Pull-up
	    PORT_PULL_OFF);

	SDA_set_inverted(
	    // <y> Invert I/O on pin
	    // <id> pad_invert
	    // <false"> Not inverted
	    // <true"> Inverted
	    false);

	SDA_set_isc(
	    // <y> Pin Input/Sense Configuration
	    // <id> pad_isc
	    // <PORT_ISC_INTDISABLE_gc"> Interrupt disabled but input buffer enabled
	    // <PORT_ISC_BOTHEDGES_gc"> Sense Both Edges
	    // <PORT_ISC_RISING_gc"> Sense Rising Edge
	    // <PORT_ISC_FALLING_gc"> Sense Falling Edge
	    // <PORT_ISC_INPUT_DISABLE_gc"> Digital Input Buffer disabled
	    // <PORT_ISC_LEVEL_gc"> Sense low Level
	    PORT_ISC_INTDISABLE_gc);

	/* set the alternate pin mux */

	PORTMUX.TWIROUTEA |= PORTMUX_TWI01_bm;

	I2C_0_init();
}

/* Configure pins and initialize registers */
void ADC_0_initialization(void)
{

	ADC_0_init();
}

/**
 * \brief System initialization
 */
void system_init()
{
	mcu_init();

	/* PORT setting on PA2 */

	// Set pin direction to input
	PIR_set_dir(PORT_DIR_IN);

	PIR_set_pull_mode(
	    // <y> Pull configuration
	    // <id> pad_pull_config
	    // <PORT_PULL_OFF"> Off
	    // <PORT_PULL_UP"> Pull-up
	    PORT_PULL_OFF);

	/* PORT setting on PA4 */

	// Set pin direction to output

	LED1_set_level(
	    // <y> Initial level
	    // <id> pad_initial_level
	    // <false"> Low
	    // <true"> High
	    false);

	LED1_set_dir(PORT_DIR_OUT);

	/* PORT setting on PA6 */

	// Set pin direction to output

	LED0_set_level(
	    // <y> Initial level
	    // <id> pad_initial_level
	    // <false"> Low
	    // <true"> High
	    false);

	LED0_set_dir(PORT_DIR_OUT);

	/* PORT setting on PD0 */

	// Set pin direction to output

	heaterTrigger_set_level(
	    // <y> Initial level
	    // <id> pad_initial_level
	    // <false"> Low
	    // <true"> High
	    false);

	heaterTrigger_set_dir(PORT_DIR_OUT);

	/* PORT setting on PD2 */

	// Disable digital input buffer
	AIN0_set_isc(PORT_ISC_INPUT_DISABLE_gc);
	// Disable pull-up resistor
	AIN0_set_pull_mode(PORT_PULL_OFF);

	/* PORT setting on PD3 */

	// Disable digital input buffer
	AIN1_set_isc(PORT_ISC_INPUT_DISABLE_gc);
	// Disable pull-up resistor
	AIN1_set_pull_mode(PORT_PULL_OFF);

	/* PORT setting on PD4 */

	// Set pin direction to output

	heaterRelay_set_level(
	    // <y> Initial level
	    // <id> pad_initial_level
	    // <false"> Low
	    // <true"> High
	    false);

	heaterRelay_set_dir(PORT_DIR_OUT);

	/* PORT setting on PD5 */

	// Set pin direction to input
	zeroCross_set_dir(PORT_DIR_IN);

	zeroCross_set_pull_mode(
	    // <y> Pull configuration
	    // <id> pad_pull_config
	    // <PORT_PULL_OFF"> Off
	    // <PORT_PULL_UP"> Pull-up
	    PORT_PULL_OFF);

	/* PORT setting on PD6 */

	// Set pin direction to output

	auxRelay_set_level(
	    // <y> Initial level
	    // <id> pad_initial_level
	    // <false"> Low
	    // <true"> High
	    false);

	auxRelay_set_dir(PORT_DIR_OUT);

	/* PORT setting on PD7 */

	// Set pin direction to output

	auxTrigger_set_level(
	    // <y> Initial level
	    // <id> pad_initial_level
	    // <false"> Low
	    // <true"> High
	    false);

	auxTrigger_set_dir(PORT_DIR_OUT);

	CLKCTRL_init();

	USART_initialization();

	USART_0_initialization();

	SLPCTRL_init();

	CPUINT_init();

	ZCD_0_initialization();

	I2C_0_initialization();

	ADC_0_initialization();

	Timer_init();

	BOD_init();
}
