daverowntree/SmartDesk/Atmel Studio/SmartDesk_V1p0/include/atmel_start_pins.h

/*
 * Code generated from START.
 *
 * This file will be overwritten when reconfiguring your START project.
 * Please copy examples or other code you want to keep to a separate file
 * to avoid losing it when reconfiguring.
 */
#ifndef ATMEL_START_PINS_H_INCLUDED
#define ATMEL_START_PINS_H_INCLUDED

#include <port.h>

/**
 * \brief Set YLine0 pull mode
 *
 * Configure pin to pull up, down or disable pull mode, supported pull
 * modes are defined by device used
 *
 * \param[in] pull_mode Pin pull mode
 */
static inline void YLine0_set_pull_mode(const enum port_pull_mode pull_mode)
{
	PORTA_set_pin_pull_mode(0, pull_mode);
}

/**
 * \brief Set YLine0 data direction
 *
 * Select if the pin data direction is input, output or disabled.
 * If disabled state is not possible, this function throws an assert.
 *
 * \param[in] direction PORT_DIR_IN  = Data direction in
 *                      PORT_DIR_OUT = Data direction out
 *                      PORT_DIR_OFF = Disables the pin
 *                      (low power state)
 */
static inline void YLine0_set_dir(const enum port_dir dir)
{
	PORTA_set_pin_dir(0, dir);
}

/**
 * \brief Set YLine0 input/sense configuration
 *
 * Enable/disable YLine0 digital input buffer and pin change interrupt,
 * select pin interrupt edge/level sensing mode
 *
 * \param[in] isc PORT_ISC_INTDISABLE_gc    = Iterrupt disabled but input buffer enabled
 *                PORT_ISC_BOTHEDGES_gc     = Sense Both Edges
 *                PORT_ISC_RISING_gc        = Sense Rising Edge
 *                PORT_ISC_FALLING_gc       = Sense Falling Edge
 *                PORT_ISC_INPUT_DISABLE_gc = Digital Input Buffer disabled
 *                PORT_ISC_LEVEL_gc         = Sense low Level
 */
static inline void YLine0_set_isc(const PORT_ISC_t isc)
{
	PORTA_pin_set_isc(0, isc);
}

/**
 * \brief Set YLine0 inverted mode
 *
 * Enable or disable inverted I/O on a pin
 *
 * \param[in] inverted true  = I/O on YLine0 is inverted
 *                     false = I/O on YLine0 is not inverted
 */
static inline void YLine0_set_inverted(const bool inverted)
{
	PORTA_pin_set_inverted(0, inverted);
}

/**
 * \brief Set YLine0 level
 *
 * Sets output level on a pin
 *
 * \param[in] level true  = Pin level set to "high" state
 *                  false = Pin level set to "low" state
 */
static inline void YLine0_set_level(const bool level)
{
	PORTA_set_pin_level(0, level);
}

/**
 * \brief Toggle output level on YLine0
 *
 * Toggle the pin level
 */
static inline void YLine0_toggle_level()
{
	PORTA_toggle_pin_level(0);
}

/**
 * \brief Get level on YLine0
 *
 * Reads the level on a pin
 */
static inline bool YLine0_get_level()
{
	return PORTA_get_pin_level(0);
}

/**
 * \brief Set XLine0 pull mode
 *
 * Configure pin to pull up, down or disable pull mode, supported pull
 * modes are defined by device used
 *
 * \param[in] pull_mode Pin pull mode
 */
static inline void XLine0_set_pull_mode(const enum port_pull_mode pull_mode)
{
	PORTA_set_pin_pull_mode(1, pull_mode);
}

/**
 * \brief Set XLine0 data direction
 *
 * Select if the pin data direction is input, output or disabled.
 * If disabled state is not possible, this function throws an assert.
 *
 * \param[in] direction PORT_DIR_IN  = Data direction in
 *                      PORT_DIR_OUT = Data direction out
 *                      PORT_DIR_OFF = Disables the pin
 *                      (low power state)
 */
static inline void XLine0_set_dir(const enum port_dir dir)
{
	PORTA_set_pin_dir(1, dir);
}

/**
 * \brief Set XLine0 input/sense configuration
 *
 * Enable/disable XLine0 digital input buffer and pin change interrupt,
 * select pin interrupt edge/level sensing mode
 *
 * \param[in] isc PORT_ISC_INTDISABLE_gc    = Iterrupt disabled but input buffer enabled
 *                PORT_ISC_BOTHEDGES_gc     = Sense Both Edges
 *                PORT_ISC_RISING_gc        = Sense Rising Edge
 *                PORT_ISC_FALLING_gc       = Sense Falling Edge
 *                PORT_ISC_INPUT_DISABLE_gc = Digital Input Buffer disabled
 *                PORT_ISC_LEVEL_gc         = Sense low Level
 */
static inline void XLine0_set_isc(const PORT_ISC_t isc)
{
	PORTA_pin_set_isc(1, isc);
}

/**
 * \brief Set XLine0 inverted mode
 *
 * Enable or disable inverted I/O on a pin
 *
 * \param[in] inverted true  = I/O on XLine0 is inverted
 *                     false = I/O on XLine0 is not inverted
 */
static inline void XLine0_set_inverted(const bool inverted)
{
	PORTA_pin_set_inverted(1, inverted);
}

/**
 * \brief Set XLine0 level
 *
 * Sets output level on a pin
 *
 * \param[in] level true  = Pin level set to "high" state
 *                  false = Pin level set to "low" state
 */
static inline void XLine0_set_level(const bool level)
{
	PORTA_set_pin_level(1, level);
}

/**
 * \brief Toggle output level on XLine0
 *
 * Toggle the pin level
 */
static inline void XLine0_toggle_level()
{
	PORTA_toggle_pin_level(1);
}

/**
 * \brief Get level on XLine0
 *
 * Reads the level on a pin
 */
static inline bool XLine0_get_level()
{
	return PORTA_get_pin_level(1);
}

/**
 * \brief Set PIR pull mode
 *
 * Configure pin to pull up, down or disable pull mode, supported pull
 * modes are defined by device used
 *
 * \param[in] pull_mode Pin pull mode
 */
static inline void PIR_set_pull_mode(const enum port_pull_mode pull_mode)
{
	PORTA_set_pin_pull_mode(2, pull_mode);
}

/**
 * \brief Set PIR data direction
 *
 * Select if the pin data direction is input, output or disabled.
 * If disabled state is not possible, this function throws an assert.
 *
 * \param[in] direction PORT_DIR_IN  = Data direction in
 *                      PORT_DIR_OUT = Data direction out
 *                      PORT_DIR_OFF = Disables the pin
 *                      (low power state)
 */
static inline void PIR_set_dir(const enum port_dir dir)
{
	PORTA_set_pin_dir(2, dir);
}

/**
 * \brief Set PIR input/sense configuration
 *
 * Enable/disable PIR digital input buffer and pin change interrupt,
 * select pin interrupt edge/level sensing mode
 *
 * \param[in] isc PORT_ISC_INTDISABLE_gc    = Iterrupt disabled but input buffer enabled
 *                PORT_ISC_BOTHEDGES_gc     = Sense Both Edges
 *                PORT_ISC_RISING_gc        = Sense Rising Edge
 *                PORT_ISC_FALLING_gc       = Sense Falling Edge
 *                PORT_ISC_INPUT_DISABLE_gc = Digital Input Buffer disabled
 *                PORT_ISC_LEVEL_gc         = Sense low Level
 */
static inline void PIR_set_isc(const PORT_ISC_t isc)
{
	PORTA_pin_set_isc(2, isc);
}

/**
 * \brief Set PIR inverted mode
 *
 * Enable or disable inverted I/O on a pin
 *
 * \param[in] inverted true  = I/O on PIR is inverted
 *                     false = I/O on PIR is not inverted
 */
static inline void PIR_set_inverted(const bool inverted)
{
	PORTA_pin_set_inverted(2, inverted);
}

/**
 * \brief Set PIR level
 *
 * Sets output level on a pin
 *
 * \param[in] level true  = Pin level set to "high" state
 *                  false = Pin level set to "low" state
 */
static inline void PIR_set_level(const bool level)
{
	PORTA_set_pin_level(2, level);
}

/**
 * \brief Toggle output level on PIR
 *
 * Toggle the pin level
 */
static inline void PIR_toggle_level()
{
	PORTA_toggle_pin_level(2);
}

/**
 * \brief Get level on PIR
 *
 * Reads the level on a pin
 */
static inline bool PIR_get_level()
{
	return PORTA_get_pin_level(2);
}

/**
 * \brief Set XLine1 pull mode
 *
 * Configure pin to pull up, down or disable pull mode, supported pull
 * modes are defined by device used
 *
 * \param[in] pull_mode Pin pull mode
 */
static inline void XLine1_set_pull_mode(const enum port_pull_mode pull_mode)
{
	PORTA_set_pin_pull_mode(3, pull_mode);
}

/**
 * \brief Set XLine1 data direction
 *
 * Select if the pin data direction is input, output or disabled.
 * If disabled state is not possible, this function throws an assert.
 *
 * \param[in] direction PORT_DIR_IN  = Data direction in
 *                      PORT_DIR_OUT = Data direction out
 *                      PORT_DIR_OFF = Disables the pin
 *                      (low power state)
 */
static inline void XLine1_set_dir(const enum port_dir dir)
{
	PORTA_set_pin_dir(3, dir);
}

/**
 * \brief Set XLine1 input/sense configuration
 *
 * Enable/disable XLine1 digital input buffer and pin change interrupt,
 * select pin interrupt edge/level sensing mode
 *
 * \param[in] isc PORT_ISC_INTDISABLE_gc    = Iterrupt disabled but input buffer enabled
 *                PORT_ISC_BOTHEDGES_gc     = Sense Both Edges
 *                PORT_ISC_RISING_gc        = Sense Rising Edge
 *                PORT_ISC_FALLING_gc       = Sense Falling Edge
 *                PORT_ISC_INPUT_DISABLE_gc = Digital Input Buffer disabled
 *                PORT_ISC_LEVEL_gc         = Sense low Level
 */
static inline void XLine1_set_isc(const PORT_ISC_t isc)
{
	PORTA_pin_set_isc(3, isc);
}

/**
 * \brief Set XLine1 inverted mode
 *
 * Enable or disable inverted I/O on a pin
 *
 * \param[in] inverted true  = I/O on XLine1 is inverted
 *                     false = I/O on XLine1 is not inverted
 */
static inline void XLine1_set_inverted(const bool inverted)
{
	PORTA_pin_set_inverted(3, inverted);
}

/**
 * \brief Set XLine1 level
 *
 * Sets output level on a pin
 *
 * \param[in] level true  = Pin level set to "high" state
 *                  false = Pin level set to "low" state
 */
static inline void XLine1_set_level(const bool level)
{
	PORTA_set_pin_level(3, level);
}

/**
 * \brief Toggle output level on XLine1
 *
 * Toggle the pin level
 */
static inline void XLine1_toggle_level()
{
	PORTA_toggle_pin_level(3);
}

/**
 * \brief Get level on XLine1
 *
 * Reads the level on a pin
 */
static inline bool XLine1_get_level()
{
	return PORTA_get_pin_level(3);
}

/**
 * \brief Set LED1 pull mode
 *
 * Configure pin to pull up, down or disable pull mode, supported pull
 * modes are defined by device used
 *
 * \param[in] pull_mode Pin pull mode
 */
static inline void LED1_set_pull_mode(const enum port_pull_mode pull_mode)
{
	PORTA_set_pin_pull_mode(4, pull_mode);
}

/**
 * \brief Set LED1 data direction
 *
 * Select if the pin data direction is input, output or disabled.
 * If disabled state is not possible, this function throws an assert.
 *
 * \param[in] direction PORT_DIR_IN  = Data direction in
 *                      PORT_DIR_OUT = Data direction out
 *                      PORT_DIR_OFF = Disables the pin
 *                      (low power state)
 */
static inline void LED1_set_dir(const enum port_dir dir)
{
	PORTA_set_pin_dir(4, dir);
}

/**
 * \brief Set LED1 input/sense configuration
 *
 * Enable/disable LED1 digital input buffer and pin change interrupt,
 * select pin interrupt edge/level sensing mode
 *
 * \param[in] isc PORT_ISC_INTDISABLE_gc    = Iterrupt disabled but input buffer enabled
 *                PORT_ISC_BOTHEDGES_gc     = Sense Both Edges
 *                PORT_ISC_RISING_gc        = Sense Rising Edge
 *                PORT_ISC_FALLING_gc       = Sense Falling Edge
 *                PORT_ISC_INPUT_DISABLE_gc = Digital Input Buffer disabled
 *                PORT_ISC_LEVEL_gc         = Sense low Level
 */
static inline void LED1_set_isc(const PORT_ISC_t isc)
{
	PORTA_pin_set_isc(4, isc);
}

/**
 * \brief Set LED1 inverted mode
 *
 * Enable or disable inverted I/O on a pin
 *
 * \param[in] inverted true  = I/O on LED1 is inverted
 *                     false = I/O on LED1 is not inverted
 */
static inline void LED1_set_inverted(const bool inverted)
{
	PORTA_pin_set_inverted(4, inverted);
}

/**
 * \brief Set LED1 level
 *
 * Sets output level on a pin
 *
 * \param[in] level true  = Pin level set to "high" state
 *                  false = Pin level set to "low" state
 */
static inline void LED1_set_level(const bool level)
{
	PORTA_set_pin_level(4, level);
}

/**
 * \brief Toggle output level on LED1
 *
 * Toggle the pin level
 */
static inline void LED1_toggle_level()
{
	PORTA_toggle_pin_level(4);
}

/**
 * \brief Get level on LED1
 *
 * Reads the level on a pin
 */
static inline bool LED1_get_level()
{
	return PORTA_get_pin_level(4);
}

/**
 * \brief Set XLine2 pull mode
 *
 * Configure pin to pull up, down or disable pull mode, supported pull
 * modes are defined by device used
 *
 * \param[in] pull_mode Pin pull mode
 */
static inline void XLine2_set_pull_mode(const enum port_pull_mode pull_mode)
{
	PORTA_set_pin_pull_mode(5, pull_mode);
}

/**
 * \brief Set XLine2 data direction
 *
 * Select if the pin data direction is input, output or disabled.
 * If disabled state is not possible, this function throws an assert.
 *
 * \param[in] direction PORT_DIR_IN  = Data direction in
 *                      PORT_DIR_OUT = Data direction out
 *                      PORT_DIR_OFF = Disables the pin
 *                      (low power state)
 */
static inline void XLine2_set_dir(const enum port_dir dir)
{
	PORTA_set_pin_dir(5, dir);
}

/**
 * \brief Set XLine2 input/sense configuration
 *
 * Enable/disable XLine2 digital input buffer and pin change interrupt,
 * select pin interrupt edge/level sensing mode
 *
 * \param[in] isc PORT_ISC_INTDISABLE_gc    = Iterrupt disabled but input buffer enabled
 *                PORT_ISC_BOTHEDGES_gc     = Sense Both Edges
 *                PORT_ISC_RISING_gc        = Sense Rising Edge
 *                PORT_ISC_FALLING_gc       = Sense Falling Edge
 *                PORT_ISC_INPUT_DISABLE_gc = Digital Input Buffer disabled
 *                PORT_ISC_LEVEL_gc         = Sense low Level
 */
static inline void XLine2_set_isc(const PORT_ISC_t isc)
{
	PORTA_pin_set_isc(5, isc);
}

/**
 * \brief Set XLine2 inverted mode
 *
 * Enable or disable inverted I/O on a pin
 *
 * \param[in] inverted true  = I/O on XLine2 is inverted
 *                     false = I/O on XLine2 is not inverted
 */
static inline void XLine2_set_inverted(const bool inverted)
{
	PORTA_pin_set_inverted(5, inverted);
}

/**
 * \brief Set XLine2 level
 *
 * Sets output level on a pin
 *
 * \param[in] level true  = Pin level set to "high" state
 *                  false = Pin level set to "low" state
 */
static inline void XLine2_set_level(const bool level)
{
	PORTA_set_pin_level(5, level);
}

/**
 * \brief Toggle output level on XLine2
 *
 * Toggle the pin level
 */
static inline void XLine2_toggle_level()
{
	PORTA_toggle_pin_level(5);
}

/**
 * \brief Get level on XLine2
 *
 * Reads the level on a pin
 */
static inline bool XLine2_get_level()
{
	return PORTA_get_pin_level(5);
}

/**
 * \brief Set LED0 pull mode
 *
 * Configure pin to pull up, down or disable pull mode, supported pull
 * modes are defined by device used
 *
 * \param[in] pull_mode Pin pull mode
 */
static inline void LED0_set_pull_mode(const enum port_pull_mode pull_mode)
{
	PORTA_set_pin_pull_mode(6, pull_mode);
}

/**
 * \brief Set LED0 data direction
 *
 * Select if the pin data direction is input, output or disabled.
 * If disabled state is not possible, this function throws an assert.
 *
 * \param[in] direction PORT_DIR_IN  = Data direction in
 *                      PORT_DIR_OUT = Data direction out
 *                      PORT_DIR_OFF = Disables the pin
 *                      (low power state)
 */
static inline void LED0_set_dir(const enum port_dir dir)
{
	PORTA_set_pin_dir(6, dir);
}

/**
 * \brief Set LED0 input/sense configuration
 *
 * Enable/disable LED0 digital input buffer and pin change interrupt,
 * select pin interrupt edge/level sensing mode
 *
 * \param[in] isc PORT_ISC_INTDISABLE_gc    = Iterrupt disabled but input buffer enabled
 *                PORT_ISC_BOTHEDGES_gc     = Sense Both Edges
 *                PORT_ISC_RISING_gc        = Sense Rising Edge
 *                PORT_ISC_FALLING_gc       = Sense Falling Edge
 *                PORT_ISC_INPUT_DISABLE_gc = Digital Input Buffer disabled
 *                PORT_ISC_LEVEL_gc         = Sense low Level
 */
static inline void LED0_set_isc(const PORT_ISC_t isc)
{
	PORTA_pin_set_isc(6, isc);
}

/**
 * \brief Set LED0 inverted mode
 *
 * Enable or disable inverted I/O on a pin
 *
 * \param[in] inverted true  = I/O on LED0 is inverted
 *                     false = I/O on LED0 is not inverted
 */
static inline void LED0_set_inverted(const bool inverted)
{
	PORTA_pin_set_inverted(6, inverted);
}

/**
 * \brief Set LED0 level
 *
 * Sets output level on a pin
 *
 * \param[in] level true  = Pin level set to "high" state
 *                  false = Pin level set to "low" state
 */
static inline void LED0_set_level(const bool level)
{
	PORTA_set_pin_level(6, level);
}

/**
 * \brief Toggle output level on LED0
 *
 * Toggle the pin level
 */
static inline void LED0_toggle_level()
{
	PORTA_toggle_pin_level(6);
}

/**
 * \brief Get level on LED0
 *
 * Reads the level on a pin
 */
static inline bool LED0_get_level()
{
	return PORTA_get_pin_level(6);
}

/**
 * \brief Set XLine3 pull mode
 *
 * Configure pin to pull up, down or disable pull mode, supported pull
 * modes are defined by device used
 *
 * \param[in] pull_mode Pin pull mode
 */
static inline void XLine3_set_pull_mode(const enum port_pull_mode pull_mode)
{
	PORTA_set_pin_pull_mode(7, pull_mode);
}

/**
 * \brief Set XLine3 data direction
 *
 * Select if the pin data direction is input, output or disabled.
 * If disabled state is not possible, this function throws an assert.
 *
 * \param[in] direction PORT_DIR_IN  = Data direction in
 *                      PORT_DIR_OUT = Data direction out
 *                      PORT_DIR_OFF = Disables the pin
 *                      (low power state)
 */
static inline void XLine3_set_dir(const enum port_dir dir)
{
	PORTA_set_pin_dir(7, dir);
}

/**
 * \brief Set XLine3 input/sense configuration
 *
 * Enable/disable XLine3 digital input buffer and pin change interrupt,
 * select pin interrupt edge/level sensing mode
 *
 * \param[in] isc PORT_ISC_INTDISABLE_gc    = Iterrupt disabled but input buffer enabled
 *                PORT_ISC_BOTHEDGES_gc     = Sense Both Edges
 *                PORT_ISC_RISING_gc        = Sense Rising Edge
 *                PORT_ISC_FALLING_gc       = Sense Falling Edge
 *                PORT_ISC_INPUT_DISABLE_gc = Digital Input Buffer disabled
 *                PORT_ISC_LEVEL_gc         = Sense low Level
 */
static inline void XLine3_set_isc(const PORT_ISC_t isc)
{
	PORTA_pin_set_isc(7, isc);
}

/**
 * \brief Set XLine3 inverted mode
 *
 * Enable or disable inverted I/O on a pin
 *
 * \param[in] inverted true  = I/O on XLine3 is inverted
 *                     false = I/O on XLine3 is not inverted
 */
static inline void XLine3_set_inverted(const bool inverted)
{
	PORTA_pin_set_inverted(7, inverted);
}

/**
 * \brief Set XLine3 level
 *
 * Sets output level on a pin
 *
 * \param[in] level true  = Pin level set to "high" state
 *                  false = Pin level set to "low" state
 */
static inline void XLine3_set_level(const bool level)
{
	PORTA_set_pin_level(7, level);
}

/**
 * \brief Toggle output level on XLine3
 *
 * Toggle the pin level
 */
static inline void XLine3_toggle_level()
{
	PORTA_toggle_pin_level(7);
}

/**
 * \brief Get level on XLine3
 *
 * Reads the level on a pin
 */
static inline bool XLine3_get_level()
{
	return PORTA_get_pin_level(7);
}

/**
 * \brief Set debug_TxD pull mode
 *
 * Configure pin to pull up, down or disable pull mode, supported pull
 * modes are defined by device used
 *
 * \param[in] pull_mode Pin pull mode
 */
static inline void debug_TxD_set_pull_mode(const enum port_pull_mode pull_mode)
{
	PORTC_set_pin_pull_mode(0, pull_mode);
}

/**
 * \brief Set debug_TxD data direction
 *
 * Select if the pin data direction is input, output or disabled.
 * If disabled state is not possible, this function throws an assert.
 *
 * \param[in] direction PORT_DIR_IN  = Data direction in
 *                      PORT_DIR_OUT = Data direction out
 *                      PORT_DIR_OFF = Disables the pin
 *                      (low power state)
 */
static inline void debug_TxD_set_dir(const enum port_dir dir)
{
	PORTC_set_pin_dir(0, dir);
}

/**
 * \brief Set debug_TxD input/sense configuration
 *
 * Enable/disable debug_TxD digital input buffer and pin change interrupt,
 * select pin interrupt edge/level sensing mode
 *
 * \param[in] isc PORT_ISC_INTDISABLE_gc    = Iterrupt disabled but input buffer enabled
 *                PORT_ISC_BOTHEDGES_gc     = Sense Both Edges
 *                PORT_ISC_RISING_gc        = Sense Rising Edge
 *                PORT_ISC_FALLING_gc       = Sense Falling Edge
 *                PORT_ISC_INPUT_DISABLE_gc = Digital Input Buffer disabled
 *                PORT_ISC_LEVEL_gc         = Sense low Level
 */
static inline void debug_TxD_set_isc(const PORT_ISC_t isc)
{
	PORTC_pin_set_isc(0, isc);
}

/**
 * \brief Set debug_TxD inverted mode
 *
 * Enable or disable inverted I/O on a pin
 *
 * \param[in] inverted true  = I/O on debug_TxD is inverted
 *                     false = I/O on debug_TxD is not inverted
 */
static inline void debug_TxD_set_inverted(const bool inverted)
{
	PORTC_pin_set_inverted(0, inverted);
}

/**
 * \brief Set debug_TxD level
 *
 * Sets output level on a pin
 *
 * \param[in] level true  = Pin level set to "high" state
 *                  false = Pin level set to "low" state
 */
static inline void debug_TxD_set_level(const bool level)
{
	PORTC_set_pin_level(0, level);
}

/**
 * \brief Toggle output level on debug_TxD
 *
 * Toggle the pin level
 */
static inline void debug_TxD_toggle_level()
{
	PORTC_toggle_pin_level(0);
}

/**
 * \brief Get level on debug_TxD
 *
 * Reads the level on a pin
 */
static inline bool debug_TxD_get_level()
{
	return PORTC_get_pin_level(0);
}

/**
 * \brief Set debug_RxD pull mode
 *
 * Configure pin to pull up, down or disable pull mode, supported pull
 * modes are defined by device used
 *
 * \param[in] pull_mode Pin pull mode
 */
static inline void debug_RxD_set_pull_mode(const enum port_pull_mode pull_mode)
{
	PORTC_set_pin_pull_mode(1, pull_mode);
}

/**
 * \brief Set debug_RxD data direction
 *
 * Select if the pin data direction is input, output or disabled.
 * If disabled state is not possible, this function throws an assert.
 *
 * \param[in] direction PORT_DIR_IN  = Data direction in
 *                      PORT_DIR_OUT = Data direction out
 *                      PORT_DIR_OFF = Disables the pin
 *                      (low power state)
 */
static inline void debug_RxD_set_dir(const enum port_dir dir)
{
	PORTC_set_pin_dir(1, dir);
}

/**
 * \brief Set debug_RxD input/sense configuration
 *
 * Enable/disable debug_RxD digital input buffer and pin change interrupt,
 * select pin interrupt edge/level sensing mode
 *
 * \param[in] isc PORT_ISC_INTDISABLE_gc    = Iterrupt disabled but input buffer enabled
 *                PORT_ISC_BOTHEDGES_gc     = Sense Both Edges
 *                PORT_ISC_RISING_gc        = Sense Rising Edge
 *                PORT_ISC_FALLING_gc       = Sense Falling Edge
 *                PORT_ISC_INPUT_DISABLE_gc = Digital Input Buffer disabled
 *                PORT_ISC_LEVEL_gc         = Sense low Level
 */
static inline void debug_RxD_set_isc(const PORT_ISC_t isc)
{
	PORTC_pin_set_isc(1, isc);
}

/**
 * \brief Set debug_RxD inverted mode
 *
 * Enable or disable inverted I/O on a pin
 *
 * \param[in] inverted true  = I/O on debug_RxD is inverted
 *                     false = I/O on debug_RxD is not inverted
 */
static inline void debug_RxD_set_inverted(const bool inverted)
{
	PORTC_pin_set_inverted(1, inverted);
}

/**
 * \brief Set debug_RxD level
 *
 * Sets output level on a pin
 *
 * \param[in] level true  = Pin level set to "high" state
 *                  false = Pin level set to "low" state
 */
static inline void debug_RxD_set_level(const bool level)
{
	PORTC_set_pin_level(1, level);
}

/**
 * \brief Toggle output level on debug_RxD
 *
 * Toggle the pin level
 */
static inline void debug_RxD_toggle_level()
{
	PORTC_toggle_pin_level(1);
}

/**
 * \brief Get level on debug_RxD
 *
 * Reads the level on a pin
 */
static inline bool debug_RxD_get_level()
{
	return PORTC_get_pin_level(1);
}

/**
 * \brief Set SDA pull mode
 *
 * Configure pin to pull up, down or disable pull mode, supported pull
 * modes are defined by device used
 *
 * \param[in] pull_mode Pin pull mode
 */
static inline void SDA_set_pull_mode(const enum port_pull_mode pull_mode)
{
	PORTC_set_pin_pull_mode(2, pull_mode);
}

/**
 * \brief Set SDA data direction
 *
 * Select if the pin data direction is input, output or disabled.
 * If disabled state is not possible, this function throws an assert.
 *
 * \param[in] direction PORT_DIR_IN  = Data direction in
 *                      PORT_DIR_OUT = Data direction out
 *                      PORT_DIR_OFF = Disables the pin
 *                      (low power state)
 */
static inline void SDA_set_dir(const enum port_dir dir)
{
	PORTC_set_pin_dir(2, dir);
}

/**
 * \brief Set SDA input/sense configuration
 *
 * Enable/disable SDA digital input buffer and pin change interrupt,
 * select pin interrupt edge/level sensing mode
 *
 * \param[in] isc PORT_ISC_INTDISABLE_gc    = Iterrupt disabled but input buffer enabled
 *                PORT_ISC_BOTHEDGES_gc     = Sense Both Edges
 *                PORT_ISC_RISING_gc        = Sense Rising Edge
 *                PORT_ISC_FALLING_gc       = Sense Falling Edge
 *                PORT_ISC_INPUT_DISABLE_gc = Digital Input Buffer disabled
 *                PORT_ISC_LEVEL_gc         = Sense low Level
 */
static inline void SDA_set_isc(const PORT_ISC_t isc)
{
	PORTC_pin_set_isc(2, isc);
}

/**
 * \brief Set SDA inverted mode
 *
 * Enable or disable inverted I/O on a pin
 *
 * \param[in] inverted true  = I/O on SDA is inverted
 *                     false = I/O on SDA is not inverted
 */
static inline void SDA_set_inverted(const bool inverted)
{
	PORTC_pin_set_inverted(2, inverted);
}

/**
 * \brief Set SDA level
 *
 * Sets output level on a pin
 *
 * \param[in] level true  = Pin level set to "high" state
 *                  false = Pin level set to "low" state
 */
static inline void SDA_set_level(const bool level)
{
	PORTC_set_pin_level(2, level);
}

/**
 * \brief Toggle output level on SDA
 *
 * Toggle the pin level
 */
static inline void SDA_toggle_level()
{
	PORTC_toggle_pin_level(2);
}

/**
 * \brief Get level on SDA
 *
 * Reads the level on a pin
 */
static inline bool SDA_get_level()
{
	return PORTC_get_pin_level(2);
}

/**
 * \brief Set SCL pull mode
 *
 * Configure pin to pull up, down or disable pull mode, supported pull
 * modes are defined by device used
 *
 * \param[in] pull_mode Pin pull mode
 */
static inline void SCL_set_pull_mode(const enum port_pull_mode pull_mode)
{
	PORTC_set_pin_pull_mode(3, pull_mode);
}

/**
 * \brief Set SCL data direction
 *
 * Select if the pin data direction is input, output or disabled.
 * If disabled state is not possible, this function throws an assert.
 *
 * \param[in] direction PORT_DIR_IN  = Data direction in
 *                      PORT_DIR_OUT = Data direction out
 *                      PORT_DIR_OFF = Disables the pin
 *                      (low power state)
 */
static inline void SCL_set_dir(const enum port_dir dir)
{
	PORTC_set_pin_dir(3, dir);
}

/**
 * \brief Set SCL input/sense configuration
 *
 * Enable/disable SCL digital input buffer and pin change interrupt,
 * select pin interrupt edge/level sensing mode
 *
 * \param[in] isc PORT_ISC_INTDISABLE_gc    = Iterrupt disabled but input buffer enabled
 *                PORT_ISC_BOTHEDGES_gc     = Sense Both Edges
 *                PORT_ISC_RISING_gc        = Sense Rising Edge
 *                PORT_ISC_FALLING_gc       = Sense Falling Edge
 *                PORT_ISC_INPUT_DISABLE_gc = Digital Input Buffer disabled
 *                PORT_ISC_LEVEL_gc         = Sense low Level
 */
static inline void SCL_set_isc(const PORT_ISC_t isc)
{
	PORTC_pin_set_isc(3, isc);
}

/**
 * \brief Set SCL inverted mode
 *
 * Enable or disable inverted I/O on a pin
 *
 * \param[in] inverted true  = I/O on SCL is inverted
 *                     false = I/O on SCL is not inverted
 */
static inline void SCL_set_inverted(const bool inverted)
{
	PORTC_pin_set_inverted(3, inverted);
}

/**
 * \brief Set SCL level
 *
 * Sets output level on a pin
 *
 * \param[in] level true  = Pin level set to "high" state
 *                  false = Pin level set to "low" state
 */
static inline void SCL_set_level(const bool level)
{
	PORTC_set_pin_level(3, level);
}

/**
 * \brief Toggle output level on SCL
 *
 * Toggle the pin level
 */
static inline void SCL_toggle_level()
{
	PORTC_toggle_pin_level(3);
}

/**
 * \brief Get level on SCL
 *
 * Reads the level on a pin
 */
static inline bool SCL_get_level()
{
	return PORTC_get_pin_level(3);
}

/**
 * \brief Set heaterTrigger pull mode
 *
 * Configure pin to pull up, down or disable pull mode, supported pull
 * modes are defined by device used
 *
 * \param[in] pull_mode Pin pull mode
 */
static inline void heaterTrigger_set_pull_mode(const enum port_pull_mode pull_mode)
{
	PORTD_set_pin_pull_mode(0, pull_mode);
}

/**
 * \brief Set heaterTrigger data direction
 *
 * Select if the pin data direction is input, output or disabled.
 * If disabled state is not possible, this function throws an assert.
 *
 * \param[in] direction PORT_DIR_IN  = Data direction in
 *                      PORT_DIR_OUT = Data direction out
 *                      PORT_DIR_OFF = Disables the pin
 *                      (low power state)
 */
static inline void heaterTrigger_set_dir(const enum port_dir dir)
{
	PORTD_set_pin_dir(0, dir);
}

/**
 * \brief Set heaterTrigger input/sense configuration
 *
 * Enable/disable heaterTrigger digital input buffer and pin change interrupt,
 * select pin interrupt edge/level sensing mode
 *
 * \param[in] isc PORT_ISC_INTDISABLE_gc    = Iterrupt disabled but input buffer enabled
 *                PORT_ISC_BOTHEDGES_gc     = Sense Both Edges
 *                PORT_ISC_RISING_gc        = Sense Rising Edge
 *                PORT_ISC_FALLING_gc       = Sense Falling Edge
 *                PORT_ISC_INPUT_DISABLE_gc = Digital Input Buffer disabled
 *                PORT_ISC_LEVEL_gc         = Sense low Level
 */
static inline void heaterTrigger_set_isc(const PORT_ISC_t isc)
{
	PORTD_pin_set_isc(0, isc);
}

/**
 * \brief Set heaterTrigger inverted mode
 *
 * Enable or disable inverted I/O on a pin
 *
 * \param[in] inverted true  = I/O on heaterTrigger is inverted
 *                     false = I/O on heaterTrigger is not inverted
 */
static inline void heaterTrigger_set_inverted(const bool inverted)
{
	PORTD_pin_set_inverted(0, inverted);
}

/**
 * \brief Set heaterTrigger level
 *
 * Sets output level on a pin
 *
 * \param[in] level true  = Pin level set to "high" state
 *                  false = Pin level set to "low" state
 */
static inline void heaterTrigger_set_level(const bool level)
{
	PORTD_set_pin_level(0, level);
}

/**
 * \brief Toggle output level on heaterTrigger
 *
 * Toggle the pin level
 */
static inline void heaterTrigger_toggle_level()
{
	PORTD_toggle_pin_level(0);
}

/**
 * \brief Get level on heaterTrigger
 *
 * Reads the level on a pin
 */
static inline bool heaterTrigger_get_level()
{
	return PORTD_get_pin_level(0);
}

/**
 * \brief Set ZCD pull mode
 *
 * Configure pin to pull up, down or disable pull mode, supported pull
 * modes are defined by device used
 *
 * \param[in] pull_mode Pin pull mode
 */
static inline void ZCD_set_pull_mode(const enum port_pull_mode pull_mode)
{
	PORTD_set_pin_pull_mode(1, pull_mode);
}

/**
 * \brief Set ZCD data direction
 *
 * Select if the pin data direction is input, output or disabled.
 * If disabled state is not possible, this function throws an assert.
 *
 * \param[in] direction PORT_DIR_IN  = Data direction in
 *                      PORT_DIR_OUT = Data direction out
 *                      PORT_DIR_OFF = Disables the pin
 *                      (low power state)
 */
static inline void ZCD_set_dir(const enum port_dir dir)
{
	PORTD_set_pin_dir(1, dir);
}

/**
 * \brief Set ZCD input/sense configuration
 *
 * Enable/disable ZCD digital input buffer and pin change interrupt,
 * select pin interrupt edge/level sensing mode
 *
 * \param[in] isc PORT_ISC_INTDISABLE_gc    = Iterrupt disabled but input buffer enabled
 *                PORT_ISC_BOTHEDGES_gc     = Sense Both Edges
 *                PORT_ISC_RISING_gc        = Sense Rising Edge
 *                PORT_ISC_FALLING_gc       = Sense Falling Edge
 *                PORT_ISC_INPUT_DISABLE_gc = Digital Input Buffer disabled
 *                PORT_ISC_LEVEL_gc         = Sense low Level
 */
static inline void ZCD_set_isc(const PORT_ISC_t isc)
{
	PORTD_pin_set_isc(1, isc);
}

/**
 * \brief Set ZCD inverted mode
 *
 * Enable or disable inverted I/O on a pin
 *
 * \param[in] inverted true  = I/O on ZCD is inverted
 *                     false = I/O on ZCD is not inverted
 */
static inline void ZCD_set_inverted(const bool inverted)
{
	PORTD_pin_set_inverted(1, inverted);
}

/**
 * \brief Set ZCD level
 *
 * Sets output level on a pin
 *
 * \param[in] level true  = Pin level set to "high" state
 *                  false = Pin level set to "low" state
 */
static inline void ZCD_set_level(const bool level)
{
	PORTD_set_pin_level(1, level);
}

/**
 * \brief Toggle output level on ZCD
 *
 * Toggle the pin level
 */
static inline void ZCD_toggle_level()
{
	PORTD_toggle_pin_level(1);
}

/**
 * \brief Get level on ZCD
 *
 * Reads the level on a pin
 */
static inline bool ZCD_get_level()
{
	return PORTD_get_pin_level(1);
}

/**
 * \brief Set AIN0 pull mode
 *
 * Configure pin to pull up, down or disable pull mode, supported pull
 * modes are defined by device used
 *
 * \param[in] pull_mode Pin pull mode
 */
static inline void AIN0_set_pull_mode(const enum port_pull_mode pull_mode)
{
	PORTD_set_pin_pull_mode(2, pull_mode);
}

/**
 * \brief Set AIN0 data direction
 *
 * Select if the pin data direction is input, output or disabled.
 * If disabled state is not possible, this function throws an assert.
 *
 * \param[in] direction PORT_DIR_IN  = Data direction in
 *                      PORT_DIR_OUT = Data direction out
 *                      PORT_DIR_OFF = Disables the pin
 *                      (low power state)
 */
static inline void AIN0_set_dir(const enum port_dir dir)
{
	PORTD_set_pin_dir(2, dir);
}

/**
 * \brief Set AIN0 input/sense configuration
 *
 * Enable/disable AIN0 digital input buffer and pin change interrupt,
 * select pin interrupt edge/level sensing mode
 *
 * \param[in] isc PORT_ISC_INTDISABLE_gc    = Iterrupt disabled but input buffer enabled
 *                PORT_ISC_BOTHEDGES_gc     = Sense Both Edges
 *                PORT_ISC_RISING_gc        = Sense Rising Edge
 *                PORT_ISC_FALLING_gc       = Sense Falling Edge
 *                PORT_ISC_INPUT_DISABLE_gc = Digital Input Buffer disabled
 *                PORT_ISC_LEVEL_gc         = Sense low Level
 */
static inline void AIN0_set_isc(const PORT_ISC_t isc)
{
	PORTD_pin_set_isc(2, isc);
}

/**
 * \brief Set AIN0 inverted mode
 *
 * Enable or disable inverted I/O on a pin
 *
 * \param[in] inverted true  = I/O on AIN0 is inverted
 *                     false = I/O on AIN0 is not inverted
 */
static inline void AIN0_set_inverted(const bool inverted)
{
	PORTD_pin_set_inverted(2, inverted);
}

/**
 * \brief Set AIN0 level
 *
 * Sets output level on a pin
 *
 * \param[in] level true  = Pin level set to "high" state
 *                  false = Pin level set to "low" state
 */
static inline void AIN0_set_level(const bool level)
{
	PORTD_set_pin_level(2, level);
}

/**
 * \brief Toggle output level on AIN0
 *
 * Toggle the pin level
 */
static inline void AIN0_toggle_level()
{
	PORTD_toggle_pin_level(2);
}

/**
 * \brief Get level on AIN0
 *
 * Reads the level on a pin
 */
static inline bool AIN0_get_level()
{
	return PORTD_get_pin_level(2);
}

/**
 * \brief Set AIN1 pull mode
 *
 * Configure pin to pull up, down or disable pull mode, supported pull
 * modes are defined by device used
 *
 * \param[in] pull_mode Pin pull mode
 */
static inline void AIN1_set_pull_mode(const enum port_pull_mode pull_mode)
{
	PORTD_set_pin_pull_mode(3, pull_mode);
}

/**
 * \brief Set AIN1 data direction
 *
 * Select if the pin data direction is input, output or disabled.
 * If disabled state is not possible, this function throws an assert.
 *
 * \param[in] direction PORT_DIR_IN  = Data direction in
 *                      PORT_DIR_OUT = Data direction out
 *                      PORT_DIR_OFF = Disables the pin
 *                      (low power state)
 */
static inline void AIN1_set_dir(const enum port_dir dir)
{
	PORTD_set_pin_dir(3, dir);
}

/**
 * \brief Set AIN1 input/sense configuration
 *
 * Enable/disable AIN1 digital input buffer and pin change interrupt,
 * select pin interrupt edge/level sensing mode
 *
 * \param[in] isc PORT_ISC_INTDISABLE_gc    = Iterrupt disabled but input buffer enabled
 *                PORT_ISC_BOTHEDGES_gc     = Sense Both Edges
 *                PORT_ISC_RISING_gc        = Sense Rising Edge
 *                PORT_ISC_FALLING_gc       = Sense Falling Edge
 *                PORT_ISC_INPUT_DISABLE_gc = Digital Input Buffer disabled
 *                PORT_ISC_LEVEL_gc         = Sense low Level
 */
static inline void AIN1_set_isc(const PORT_ISC_t isc)
{
	PORTD_pin_set_isc(3, isc);
}

/**
 * \brief Set AIN1 inverted mode
 *
 * Enable or disable inverted I/O on a pin
 *
 * \param[in] inverted true  = I/O on AIN1 is inverted
 *                     false = I/O on AIN1 is not inverted
 */
static inline void AIN1_set_inverted(const bool inverted)
{
	PORTD_pin_set_inverted(3, inverted);
}

/**
 * \brief Set AIN1 level
 *
 * Sets output level on a pin
 *
 * \param[in] level true  = Pin level set to "high" state
 *                  false = Pin level set to "low" state
 */
static inline void AIN1_set_level(const bool level)
{
	PORTD_set_pin_level(3, level);
}

/**
 * \brief Toggle output level on AIN1
 *
 * Toggle the pin level
 */
static inline void AIN1_toggle_level()
{
	PORTD_toggle_pin_level(3);
}

/**
 * \brief Get level on AIN1
 *
 * Reads the level on a pin
 */
static inline bool AIN1_get_level()
{
	return PORTD_get_pin_level(3);
}

/**
 * \brief Set heaterRelay pull mode
 *
 * Configure pin to pull up, down or disable pull mode, supported pull
 * modes are defined by device used
 *
 * \param[in] pull_mode Pin pull mode
 */
static inline void heaterRelay_set_pull_mode(const enum port_pull_mode pull_mode)
{
	PORTD_set_pin_pull_mode(4, pull_mode);
}

/**
 * \brief Set heaterRelay data direction
 *
 * Select if the pin data direction is input, output or disabled.
 * If disabled state is not possible, this function throws an assert.
 *
 * \param[in] direction PORT_DIR_IN  = Data direction in
 *                      PORT_DIR_OUT = Data direction out
 *                      PORT_DIR_OFF = Disables the pin
 *                      (low power state)
 */
static inline void heaterRelay_set_dir(const enum port_dir dir)
{
	PORTD_set_pin_dir(4, dir);
}

/**
 * \brief Set heaterRelay input/sense configuration
 *
 * Enable/disable heaterRelay digital input buffer and pin change interrupt,
 * select pin interrupt edge/level sensing mode
 *
 * \param[in] isc PORT_ISC_INTDISABLE_gc    = Iterrupt disabled but input buffer enabled
 *                PORT_ISC_BOTHEDGES_gc     = Sense Both Edges
 *                PORT_ISC_RISING_gc        = Sense Rising Edge
 *                PORT_ISC_FALLING_gc       = Sense Falling Edge
 *                PORT_ISC_INPUT_DISABLE_gc = Digital Input Buffer disabled
 *                PORT_ISC_LEVEL_gc         = Sense low Level
 */
static inline void heaterRelay_set_isc(const PORT_ISC_t isc)
{
	PORTD_pin_set_isc(4, isc);
}

/**
 * \brief Set heaterRelay inverted mode
 *
 * Enable or disable inverted I/O on a pin
 *
 * \param[in] inverted true  = I/O on heaterRelay is inverted
 *                     false = I/O on heaterRelay is not inverted
 */
static inline void heaterRelay_set_inverted(const bool inverted)
{
	PORTD_pin_set_inverted(4, inverted);
}

/**
 * \brief Set heaterRelay level
 *
 * Sets output level on a pin
 *
 * \param[in] level true  = Pin level set to "high" state
 *                  false = Pin level set to "low" state
 */
static inline void heaterRelay_set_level(const bool level)
{
	PORTD_set_pin_level(4, level);
}

/**
 * \brief Toggle output level on heaterRelay
 *
 * Toggle the pin level
 */
static inline void heaterRelay_toggle_level()
{
	PORTD_toggle_pin_level(4);
}

/**
 * \brief Get level on heaterRelay
 *
 * Reads the level on a pin
 */
static inline bool heaterRelay_get_level()
{
	return PORTD_get_pin_level(4);
}

/**
 * \brief Set zeroCross pull mode
 *
 * Configure pin to pull up, down or disable pull mode, supported pull
 * modes are defined by device used
 *
 * \param[in] pull_mode Pin pull mode
 */
static inline void zeroCross_set_pull_mode(const enum port_pull_mode pull_mode)
{
	PORTD_set_pin_pull_mode(5, pull_mode);
}

/**
 * \brief Set zeroCross data direction
 *
 * Select if the pin data direction is input, output or disabled.
 * If disabled state is not possible, this function throws an assert.
 *
 * \param[in] direction PORT_DIR_IN  = Data direction in
 *                      PORT_DIR_OUT = Data direction out
 *                      PORT_DIR_OFF = Disables the pin
 *                      (low power state)
 */
static inline void zeroCross_set_dir(const enum port_dir dir)
{
	PORTD_set_pin_dir(5, dir);
}

/**
 * \brief Set zeroCross input/sense configuration
 *
 * Enable/disable zeroCross digital input buffer and pin change interrupt,
 * select pin interrupt edge/level sensing mode
 *
 * \param[in] isc PORT_ISC_INTDISABLE_gc    = Iterrupt disabled but input buffer enabled
 *                PORT_ISC_BOTHEDGES_gc     = Sense Both Edges
 *                PORT_ISC_RISING_gc        = Sense Rising Edge
 *                PORT_ISC_FALLING_gc       = Sense Falling Edge
 *                PORT_ISC_INPUT_DISABLE_gc = Digital Input Buffer disabled
 *                PORT_ISC_LEVEL_gc         = Sense low Level
 */
static inline void zeroCross_set_isc(const PORT_ISC_t isc)
{
	PORTD_pin_set_isc(5, isc);
}

/**
 * \brief Set zeroCross inverted mode
 *
 * Enable or disable inverted I/O on a pin
 *
 * \param[in] inverted true  = I/O on zeroCross is inverted
 *                     false = I/O on zeroCross is not inverted
 */
static inline void zeroCross_set_inverted(const bool inverted)
{
	PORTD_pin_set_inverted(5, inverted);
}

/**
 * \brief Set zeroCross level
 *
 * Sets output level on a pin
 *
 * \param[in] level true  = Pin level set to "high" state
 *                  false = Pin level set to "low" state
 */
static inline void zeroCross_set_level(const bool level)
{
	PORTD_set_pin_level(5, level);
}

/**
 * \brief Toggle output level on zeroCross
 *
 * Toggle the pin level
 */
static inline void zeroCross_toggle_level()
{
	PORTD_toggle_pin_level(5);
}

/**
 * \brief Get level on zeroCross
 *
 * Reads the level on a pin
 */
static inline bool zeroCross_get_level()
{
	return PORTD_get_pin_level(5);
}

/**
 * \brief Set auxRelay pull mode
 *
 * Configure pin to pull up, down or disable pull mode, supported pull
 * modes are defined by device used
 *
 * \param[in] pull_mode Pin pull mode
 */
static inline void auxRelay_set_pull_mode(const enum port_pull_mode pull_mode)
{
	PORTD_set_pin_pull_mode(6, pull_mode);
}

/**
 * \brief Set auxRelay data direction
 *
 * Select if the pin data direction is input, output or disabled.
 * If disabled state is not possible, this function throws an assert.
 *
 * \param[in] direction PORT_DIR_IN  = Data direction in
 *                      PORT_DIR_OUT = Data direction out
 *                      PORT_DIR_OFF = Disables the pin
 *                      (low power state)
 */
static inline void auxRelay_set_dir(const enum port_dir dir)
{
	PORTD_set_pin_dir(6, dir);
}

/**
 * \brief Set auxRelay input/sense configuration
 *
 * Enable/disable auxRelay digital input buffer and pin change interrupt,
 * select pin interrupt edge/level sensing mode
 *
 * \param[in] isc PORT_ISC_INTDISABLE_gc    = Iterrupt disabled but input buffer enabled
 *                PORT_ISC_BOTHEDGES_gc     = Sense Both Edges
 *                PORT_ISC_RISING_gc        = Sense Rising Edge
 *                PORT_ISC_FALLING_gc       = Sense Falling Edge
 *                PORT_ISC_INPUT_DISABLE_gc = Digital Input Buffer disabled
 *                PORT_ISC_LEVEL_gc         = Sense low Level
 */
static inline void auxRelay_set_isc(const PORT_ISC_t isc)
{
	PORTD_pin_set_isc(6, isc);
}

/**
 * \brief Set auxRelay inverted mode
 *
 * Enable or disable inverted I/O on a pin
 *
 * \param[in] inverted true  = I/O on auxRelay is inverted
 *                     false = I/O on auxRelay is not inverted
 */
static inline void auxRelay_set_inverted(const bool inverted)
{
	PORTD_pin_set_inverted(6, inverted);
}

/**
 * \brief Set auxRelay level
 *
 * Sets output level on a pin
 *
 * \param[in] level true  = Pin level set to "high" state
 *                  false = Pin level set to "low" state
 */
static inline void auxRelay_set_level(const bool level)
{
	PORTD_set_pin_level(6, level);
}

/**
 * \brief Toggle output level on auxRelay
 *
 * Toggle the pin level
 */
static inline void auxRelay_toggle_level()
{
	PORTD_toggle_pin_level(6);
}

/**
 * \brief Get level on auxRelay
 *
 * Reads the level on a pin
 */
static inline bool auxRelay_get_level()
{
	return PORTD_get_pin_level(6);
}

/**
 * \brief Set auxTrigger pull mode
 *
 * Configure pin to pull up, down or disable pull mode, supported pull
 * modes are defined by device used
 *
 * \param[in] pull_mode Pin pull mode
 */
static inline void auxTrigger_set_pull_mode(const enum port_pull_mode pull_mode)
{
	PORTD_set_pin_pull_mode(7, pull_mode);
}

/**
 * \brief Set auxTrigger data direction
 *
 * Select if the pin data direction is input, output or disabled.
 * If disabled state is not possible, this function throws an assert.
 *
 * \param[in] direction PORT_DIR_IN  = Data direction in
 *                      PORT_DIR_OUT = Data direction out
 *                      PORT_DIR_OFF = Disables the pin
 *                      (low power state)
 */
static inline void auxTrigger_set_dir(const enum port_dir dir)
{
	PORTD_set_pin_dir(7, dir);
}

/**
 * \brief Set auxTrigger input/sense configuration
 *
 * Enable/disable auxTrigger digital input buffer and pin change interrupt,
 * select pin interrupt edge/level sensing mode
 *
 * \param[in] isc PORT_ISC_INTDISABLE_gc    = Iterrupt disabled but input buffer enabled
 *                PORT_ISC_BOTHEDGES_gc     = Sense Both Edges
 *                PORT_ISC_RISING_gc        = Sense Rising Edge
 *                PORT_ISC_FALLING_gc       = Sense Falling Edge
 *                PORT_ISC_INPUT_DISABLE_gc = Digital Input Buffer disabled
 *                PORT_ISC_LEVEL_gc         = Sense low Level
 */
static inline void auxTrigger_set_isc(const PORT_ISC_t isc)
{
	PORTD_pin_set_isc(7, isc);
}

/**
 * \brief Set auxTrigger inverted mode
 *
 * Enable or disable inverted I/O on a pin
 *
 * \param[in] inverted true  = I/O on auxTrigger is inverted
 *                     false = I/O on auxTrigger is not inverted
 */
static inline void auxTrigger_set_inverted(const bool inverted)
{
	PORTD_pin_set_inverted(7, inverted);
}

/**
 * \brief Set auxTrigger level
 *
 * Sets output level on a pin
 *
 * \param[in] level true  = Pin level set to "high" state
 *                  false = Pin level set to "low" state
 */
static inline void auxTrigger_set_level(const bool level)
{
	PORTD_set_pin_level(7, level);
}

/**
 * \brief Toggle output level on auxTrigger
 *
 * Toggle the pin level
 */
static inline void auxTrigger_toggle_level()
{
	PORTD_toggle_pin_level(7);
}

/**
 * \brief Get level on auxTrigger
 *
 * Reads the level on a pin
 */
static inline bool auxTrigger_get_level()
{
	return PORTD_get_pin_level(7);
}

/**
 * \brief Set TxD pull mode
 *
 * Configure pin to pull up, down or disable pull mode, supported pull
 * modes are defined by device used
 *
 * \param[in] pull_mode Pin pull mode
 */
static inline void TxD_set_pull_mode(const enum port_pull_mode pull_mode)
{
	PORTF_set_pin_pull_mode(0, pull_mode);
}

/**
 * \brief Set TxD data direction
 *
 * Select if the pin data direction is input, output or disabled.
 * If disabled state is not possible, this function throws an assert.
 *
 * \param[in] direction PORT_DIR_IN  = Data direction in
 *                      PORT_DIR_OUT = Data direction out
 *                      PORT_DIR_OFF = Disables the pin
 *                      (low power state)
 */
static inline void TxD_set_dir(const enum port_dir dir)
{
	PORTF_set_pin_dir(0, dir);
}

/**
 * \brief Set TxD input/sense configuration
 *
 * Enable/disable TxD digital input buffer and pin change interrupt,
 * select pin interrupt edge/level sensing mode
 *
 * \param[in] isc PORT_ISC_INTDISABLE_gc    = Iterrupt disabled but input buffer enabled
 *                PORT_ISC_BOTHEDGES_gc     = Sense Both Edges
 *                PORT_ISC_RISING_gc        = Sense Rising Edge
 *                PORT_ISC_FALLING_gc       = Sense Falling Edge
 *                PORT_ISC_INPUT_DISABLE_gc = Digital Input Buffer disabled
 *                PORT_ISC_LEVEL_gc         = Sense low Level
 */
static inline void TxD_set_isc(const PORT_ISC_t isc)
{
	PORTF_pin_set_isc(0, isc);
}

/**
 * \brief Set TxD inverted mode
 *
 * Enable or disable inverted I/O on a pin
 *
 * \param[in] inverted true  = I/O on TxD is inverted
 *                     false = I/O on TxD is not inverted
 */
static inline void TxD_set_inverted(const bool inverted)
{
	PORTF_pin_set_inverted(0, inverted);
}

/**
 * \brief Set TxD level
 *
 * Sets output level on a pin
 *
 * \param[in] level true  = Pin level set to "high" state
 *                  false = Pin level set to "low" state
 */
static inline void TxD_set_level(const bool level)
{
	PORTF_set_pin_level(0, level);
}

/**
 * \brief Toggle output level on TxD
 *
 * Toggle the pin level
 */
static inline void TxD_toggle_level()
{
	PORTF_toggle_pin_level(0);
}

/**
 * \brief Get level on TxD
 *
 * Reads the level on a pin
 */
static inline bool TxD_get_level()
{
	return PORTF_get_pin_level(0);
}

/**
 * \brief Set RxD pull mode
 *
 * Configure pin to pull up, down or disable pull mode, supported pull
 * modes are defined by device used
 *
 * \param[in] pull_mode Pin pull mode
 */
static inline void RxD_set_pull_mode(const enum port_pull_mode pull_mode)
{
	PORTF_set_pin_pull_mode(1, pull_mode);
}

/**
 * \brief Set RxD data direction
 *
 * Select if the pin data direction is input, output or disabled.
 * If disabled state is not possible, this function throws an assert.
 *
 * \param[in] direction PORT_DIR_IN  = Data direction in
 *                      PORT_DIR_OUT = Data direction out
 *                      PORT_DIR_OFF = Disables the pin
 *                      (low power state)
 */
static inline void RxD_set_dir(const enum port_dir dir)
{
	PORTF_set_pin_dir(1, dir);
}

/**
 * \brief Set RxD input/sense configuration
 *
 * Enable/disable RxD digital input buffer and pin change interrupt,
 * select pin interrupt edge/level sensing mode
 *
 * \param[in] isc PORT_ISC_INTDISABLE_gc    = Iterrupt disabled but input buffer enabled
 *                PORT_ISC_BOTHEDGES_gc     = Sense Both Edges
 *                PORT_ISC_RISING_gc        = Sense Rising Edge
 *                PORT_ISC_FALLING_gc       = Sense Falling Edge
 *                PORT_ISC_INPUT_DISABLE_gc = Digital Input Buffer disabled
 *                PORT_ISC_LEVEL_gc         = Sense low Level
 */
static inline void RxD_set_isc(const PORT_ISC_t isc)
{
	PORTF_pin_set_isc(1, isc);
}

/**
 * \brief Set RxD inverted mode
 *
 * Enable or disable inverted I/O on a pin
 *
 * \param[in] inverted true  = I/O on RxD is inverted
 *                     false = I/O on RxD is not inverted
 */
static inline void RxD_set_inverted(const bool inverted)
{
	PORTF_pin_set_inverted(1, inverted);
}

/**
 * \brief Set RxD level
 *
 * Sets output level on a pin
 *
 * \param[in] level true  = Pin level set to "high" state
 *                  false = Pin level set to "low" state
 */
static inline void RxD_set_level(const bool level)
{
	PORTF_set_pin_level(1, level);
}

/**
 * \brief Toggle output level on RxD
 *
 * Toggle the pin level
 */
static inline void RxD_toggle_level()
{
	PORTF_toggle_pin_level(1);
}

/**
 * \brief Get level on RxD
 *
 * Reads the level on a pin
 */
static inline bool RxD_get_level()
{
	return PORTF_get_pin_level(1);
}

#endif /* ATMEL_START_PINS_H_INCLUDED */
