daverowntree/SmartDesk/Atmel Studio/SmartDesk_V1p0/atmel_start.h

#ifndef ATMEL_START_H_INCLUDED
#define ATMEL_START_H_INCLUDED

#ifdef __cplusplus
extern "C" {
#endif

#include "include/driver_init.h"
#include "include/atmel_start_pins.h"

#include "touch.h"

/**
 * Initializes MCU, drivers and middleware in the project
 **/
void atmel_start_init(void);

#ifdef __cplusplus
}
#endif
#endif
